na103/rainbow100-gs2/img/DEC_5015687_RainbowGraphicsCard.jpg

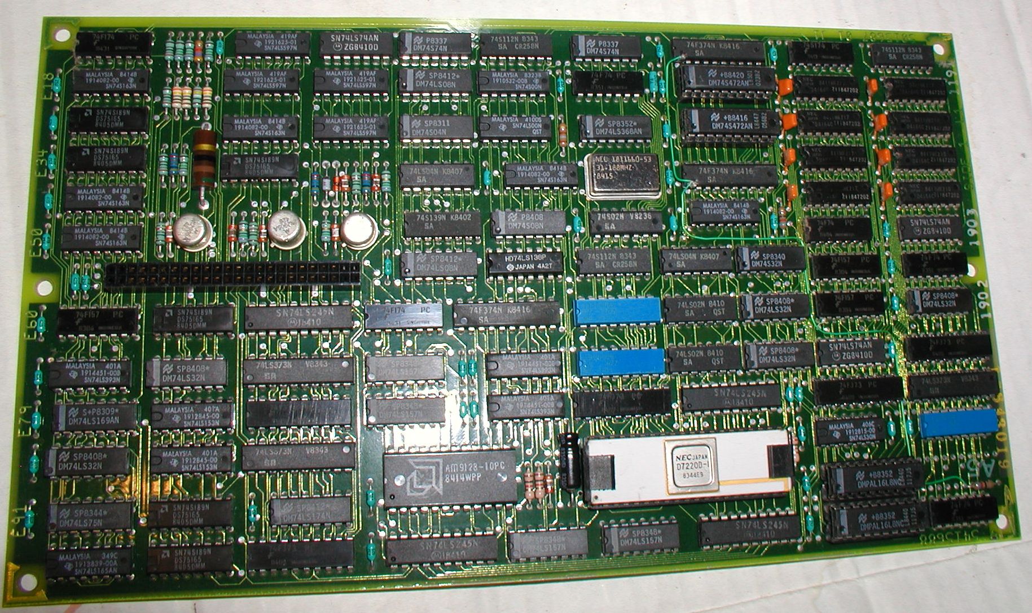
img/DEC_5015687_RainbowGraphicsCard.jpg
