na103/rainbow100-gs2/img/gimp_routing.PNG

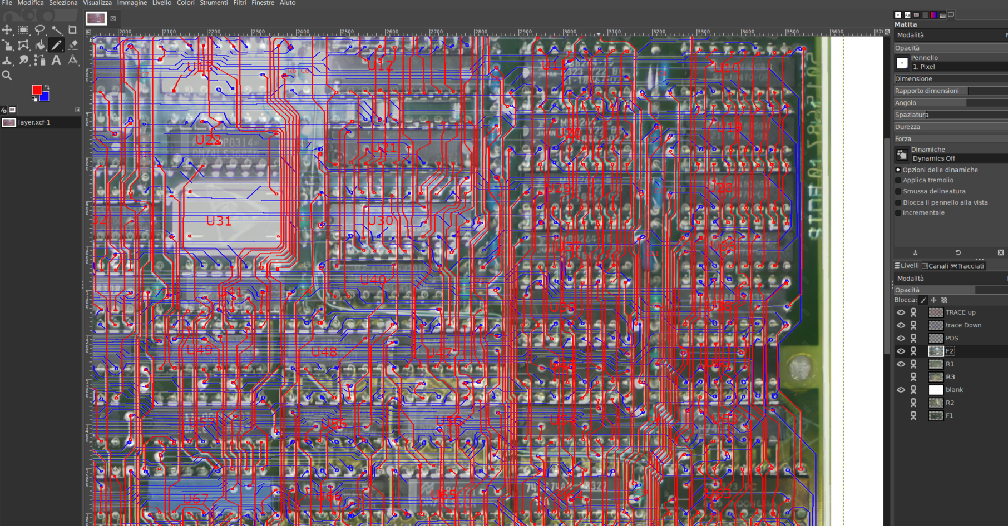
img/gimp_routing.PNG
