na103/rainbow100-gs2/img/routing.png

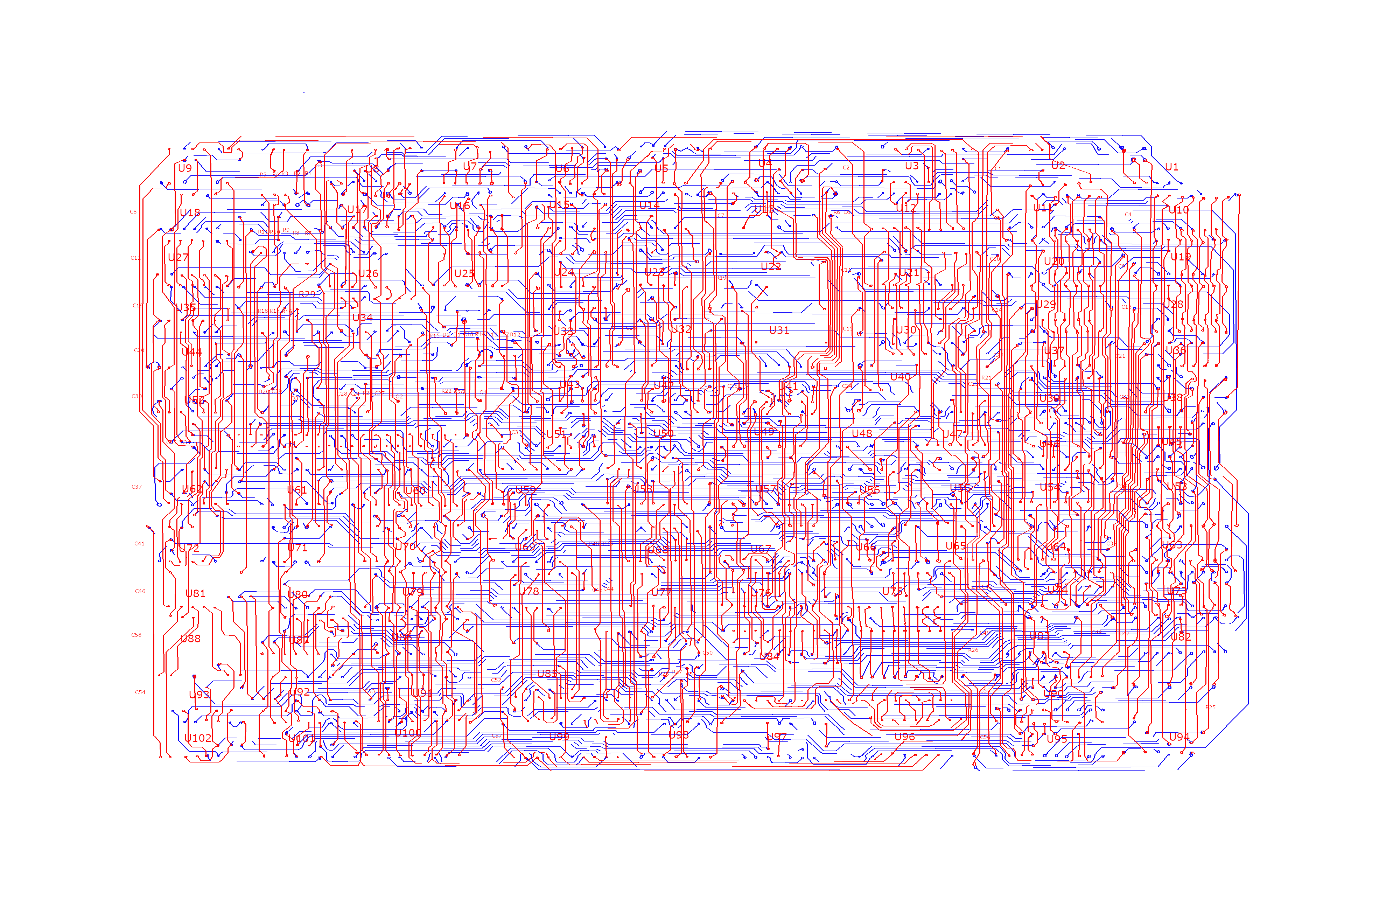
img/routing.png
