na103/rainbow100-gs2/kicad/Graphics-V2/CLUTAddress.sch

## KiCad design kicad/Graphics-V2/CLUTAddress.sch (2023-01-17)

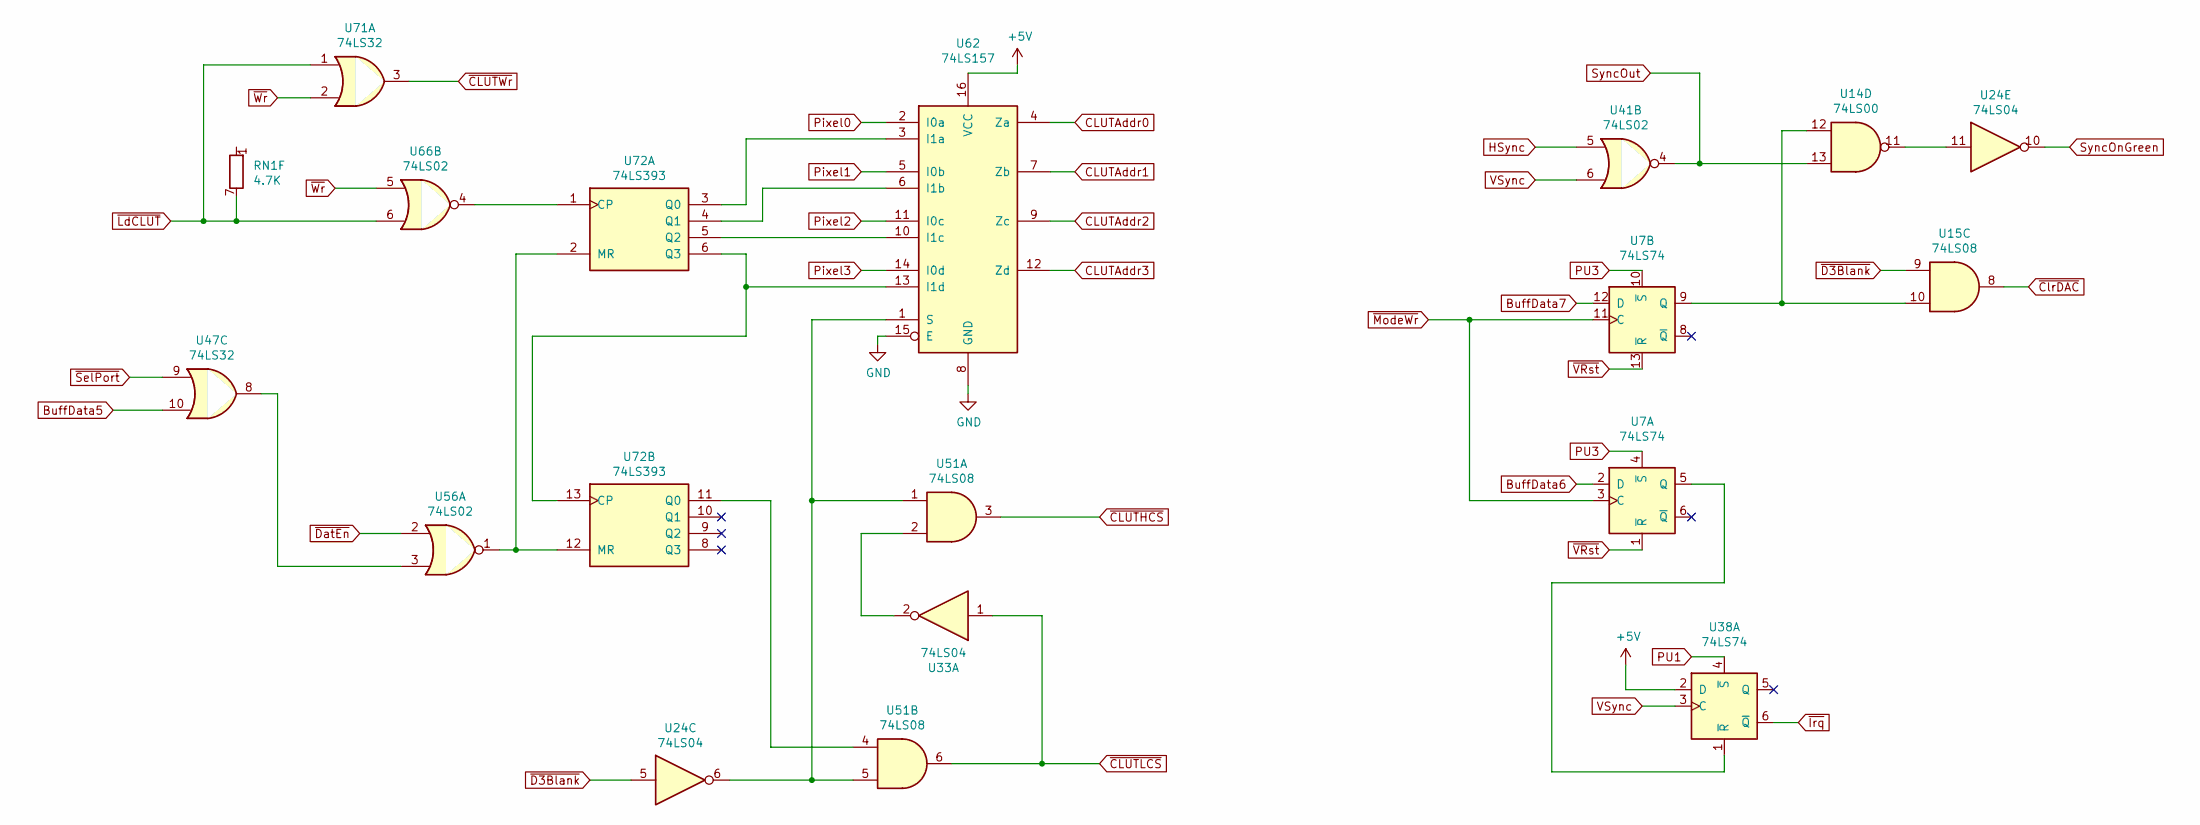
[picture p5: schematic CLUTAddress.sch]

Parts:
RN1: 4.7K; R_Array_SIP8
U7, U38: 74LS74; DIP-14_W7.62mm
U14: 74LS00; DIP-14_W7.62mm
U15, U51: 74LS08; DIP-14_W7.62mm
U24, U33: 74LS04; DIP-14_W7.62mm
U41, U56, U66: 74LS02; DIP-14_W7.62mm
U47, U71: 74LS32; DIP-14_W7.62mm
U62: 74LS157; DIP-16_W7.62mm
U72: 74LS393; DIP-14_W7.62mm

Connections:
+5V: U38.2 (D), U62.16 (VCC)
BuffData5: U47.10
BuffData6: U7.2 (D)
BuffData7: U7.12 (D)
CLUTAddr0: U62.4 (Za)
CLUTAddr1: U62.7 (Zb)
CLUTAddr2: U62.9 (Zc)
CLUTAddr3: U62.12 (Zd)
GND: U62.8 (GND), U62.15 (E)
HSync: U41.5
unnamed: U14.11, U24.11
unnamed: U7.9 (Q), U14.12, U15.10
unnamed: U24.6, U51.1, U51.5, U62.1 (S)
unnamed: U33.2, U51.2
unnamed: U7.5 (Q), U38.1 (~R)
unnamed: U47.8, U56.3
unnamed: U51.4, U72.11 (Q0)
unnamed: U56.1, U72.2 (MR), U72.12 (MR)
unnamed: U62.3 (I1a), U72.3 (Q0)
unnamed: U62.6 (I1b), U72.4 (Q1)
unnamed: U62.10 (I1c), U72.5 (Q2)
unnamed: U62.13 (I1d), U72.6 (Q3), U72.13 (CP)
unnamed: U66.4, U72.1 (CP)
PU1: U38.4 (~S)
PU3: U7.4 (~S), U7.10 (~S)
Pixel0: U62.2 (I0a)
Pixel1: U62.5 (I0b)
Pixel2: U62.11 (I0c)
Pixel3: U62.14 (I0d)
SyncOnGreen: U24.10
SyncOut: U14.13, U41.4
VSync: U38.3 (C), U41.6
~CLUTHCS: U51.3
~CLUTLCS: U33.1, U51.6
~CLUTWr: U71.3
~ClrDAC: U15.8
~D3Blank: U15.9, U24.5
~DatEn: U56.2
~Irq: U38.6 (~Q)
~LdCLUT: RN1.7 (R6.2), U66.6, U71.1
~ModeWr: U7.3 (C), U7.11 (C)
~SelPort: U47.9
~VRst: U7.1 (~R), U7.13 (~R)
~Wr: U66.5, U71.2
