na103/rainbow100-gs2/kicad/Graphics-V2/ColorLUT.sch

## KiCad design kicad/Graphics-V2/ColorLUT.sch (2023-01-17)

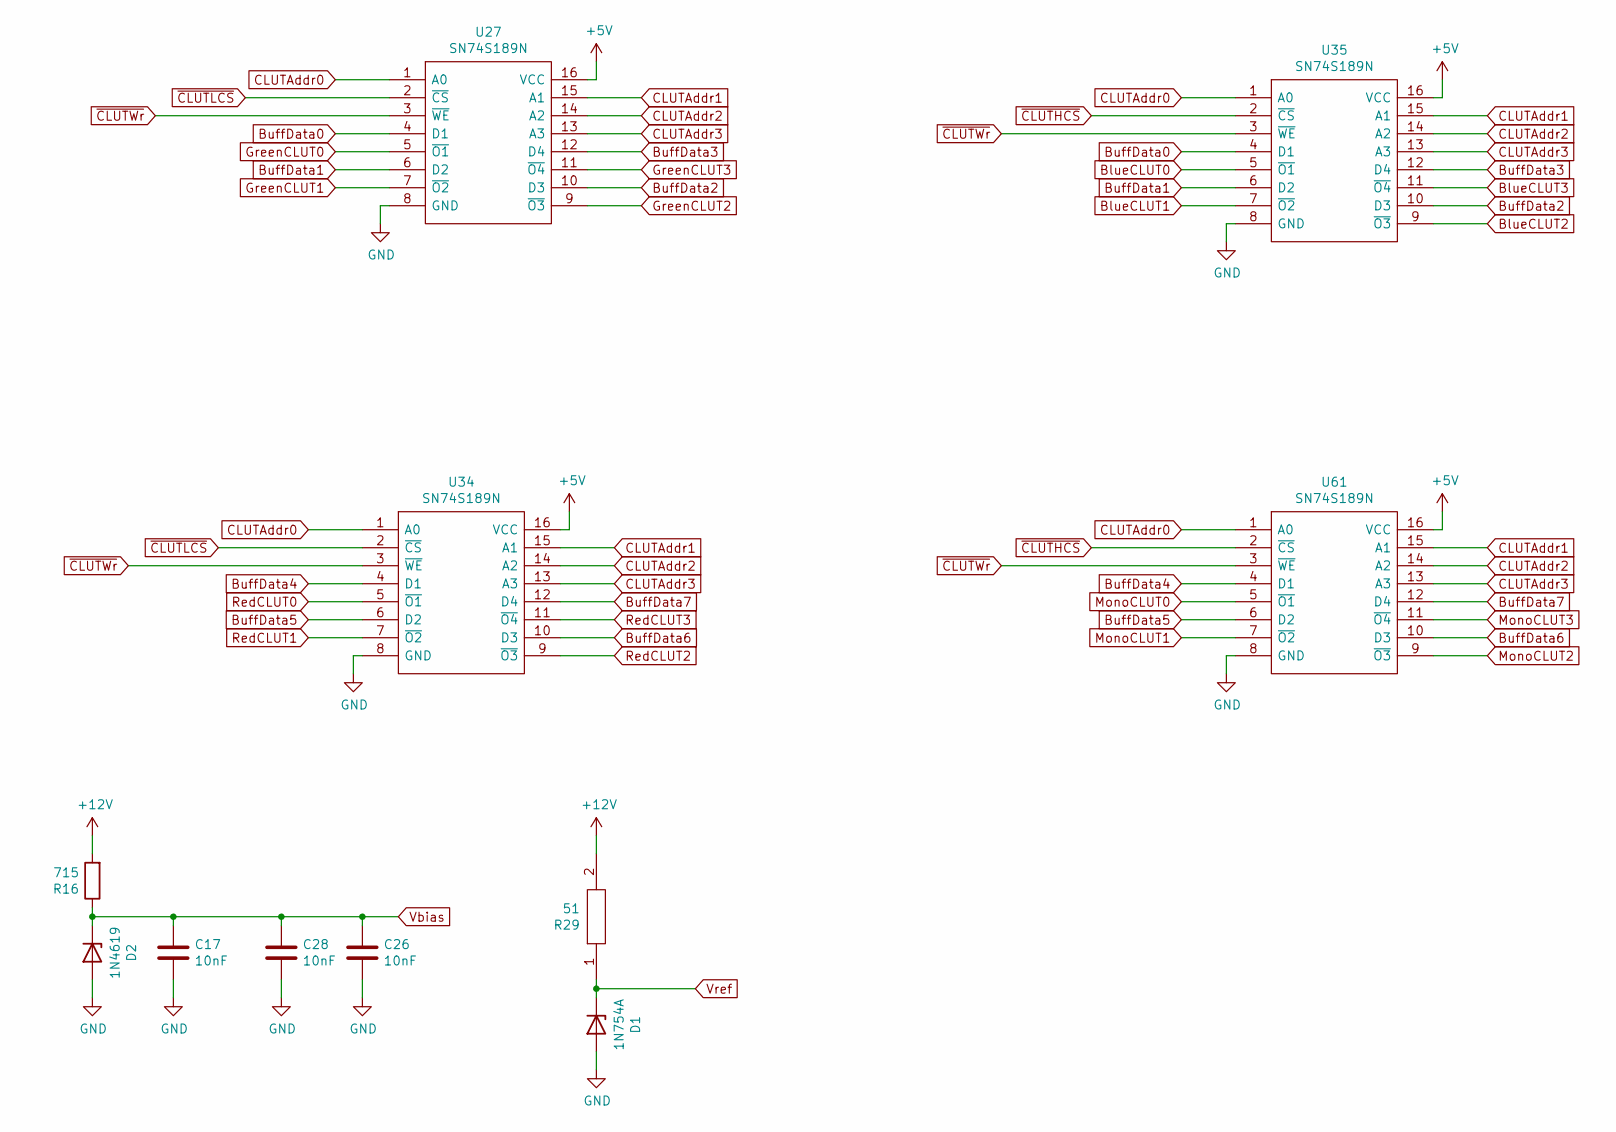
[picture p6: schematic ColorLUT.sch]

Parts:
C17, C26, C28: 10nF; C_Axial_L3.8mm_D2.6mm_P10.00mm_Horizontal
D1: 1N754A; D_DO-35_SOD27_P10.16mm_Horizontal
D2: 1N4619; D_DO-35_SOD27_P10.16mm_Horizontal
R16: 715; R_Axial_DIN0207_L6.3mm_D2.5mm_P10.16mm_Horizontal
R29: 51; RESAD2968W80L1140D457; Mouser Part Number 588-WHC51RFET
U27, U34, U35, U61: SN74S189N; DIP-16_W7.62mm_Socket; Manufacturer_Part_Number SN74S189N

Connections:
+5V: U27.16 (VCC), U34.16 (VCC), U35.16 (VCC), U61.16 (VCC)
+12V: R16.2, R29.2
BlueCLUT0: U35.5 (~O1)
BlueCLUT1: U35.7 (~O2)
BlueCLUT2: U35.9 (~O3)
BlueCLUT3: U35.11 (~O4)
BuffData0: U27.4 (D1), U35.4 (D1)
BuffData1: U27.6 (D2), U35.6 (D2)
BuffData2: U27.10 (D3), U35.10 (D3)
BuffData3: U27.12 (D4), U35.12 (D4)
BuffData4: U34.4 (D1), U61.4 (D1)
BuffData5: U34.6 (D2), U61.6 (D2)
BuffData6: U34.10 (D3), U61.10 (D3)
BuffData7: U34.12 (D4), U61.12 (D4)
CLUTAddr0: U27.1 (A0), U34.1 (A0), U35.1 (A0), U61.1 (A0)
CLUTAddr1: U27.15 (A1), U34.15 (A1), U35.15 (A1), U61.15 (A1)
CLUTAddr2: U27.14 (A2), U34.14 (A2), U35.14 (A2), U61.14 (A2)
CLUTAddr3: U27.13 (A3), U34.13 (A3), U35.13 (A3), U61.13 (A3)
GND: C17.2, C26.2, C28.2, D1.2 (A), D2.2 (A), U27.8 (GND), U34.8 (GND), U35.8 (GND), U61.8 (GND)
GreenCLUT0: U27.5 (~O1)
GreenCLUT1: U27.7 (~O2)
GreenCLUT2: U27.9 (~O3)
GreenCLUT3: U27.11 (~O4)
MonoCLUT0: U61.5 (~O1)
MonoCLUT1: U61.7 (~O2)
MonoCLUT2: U61.9 (~O3)
MonoCLUT3: U61.11 (~O4)
RedCLUT0: U34.5 (~O1)
RedCLUT1: U34.7 (~O2)
RedCLUT2: U34.9 (~O3)
RedCLUT3: U34.11 (~O4)
Vbias: C17.1, C26.1, C28.1, D2.1 (K), R16.1
Vref: D1.1 (K), R29.1
~CLUTHCS: U35.2 (~CS), U61.2 (~CS)
~CLUTLCS: U27.2 (~CS), U34.2 (~CS)
~CLUTWr: U27.3 (~WE), U34.3 (~WE), U35.3 (~WE), U61.3 (~WE)
