na103/rainbow100-gs2/kicad/Graphics-V2/CombinerControl.sch

## KiCad design kicad/Graphics-V2/CombinerControl.sch (2023-01-17)

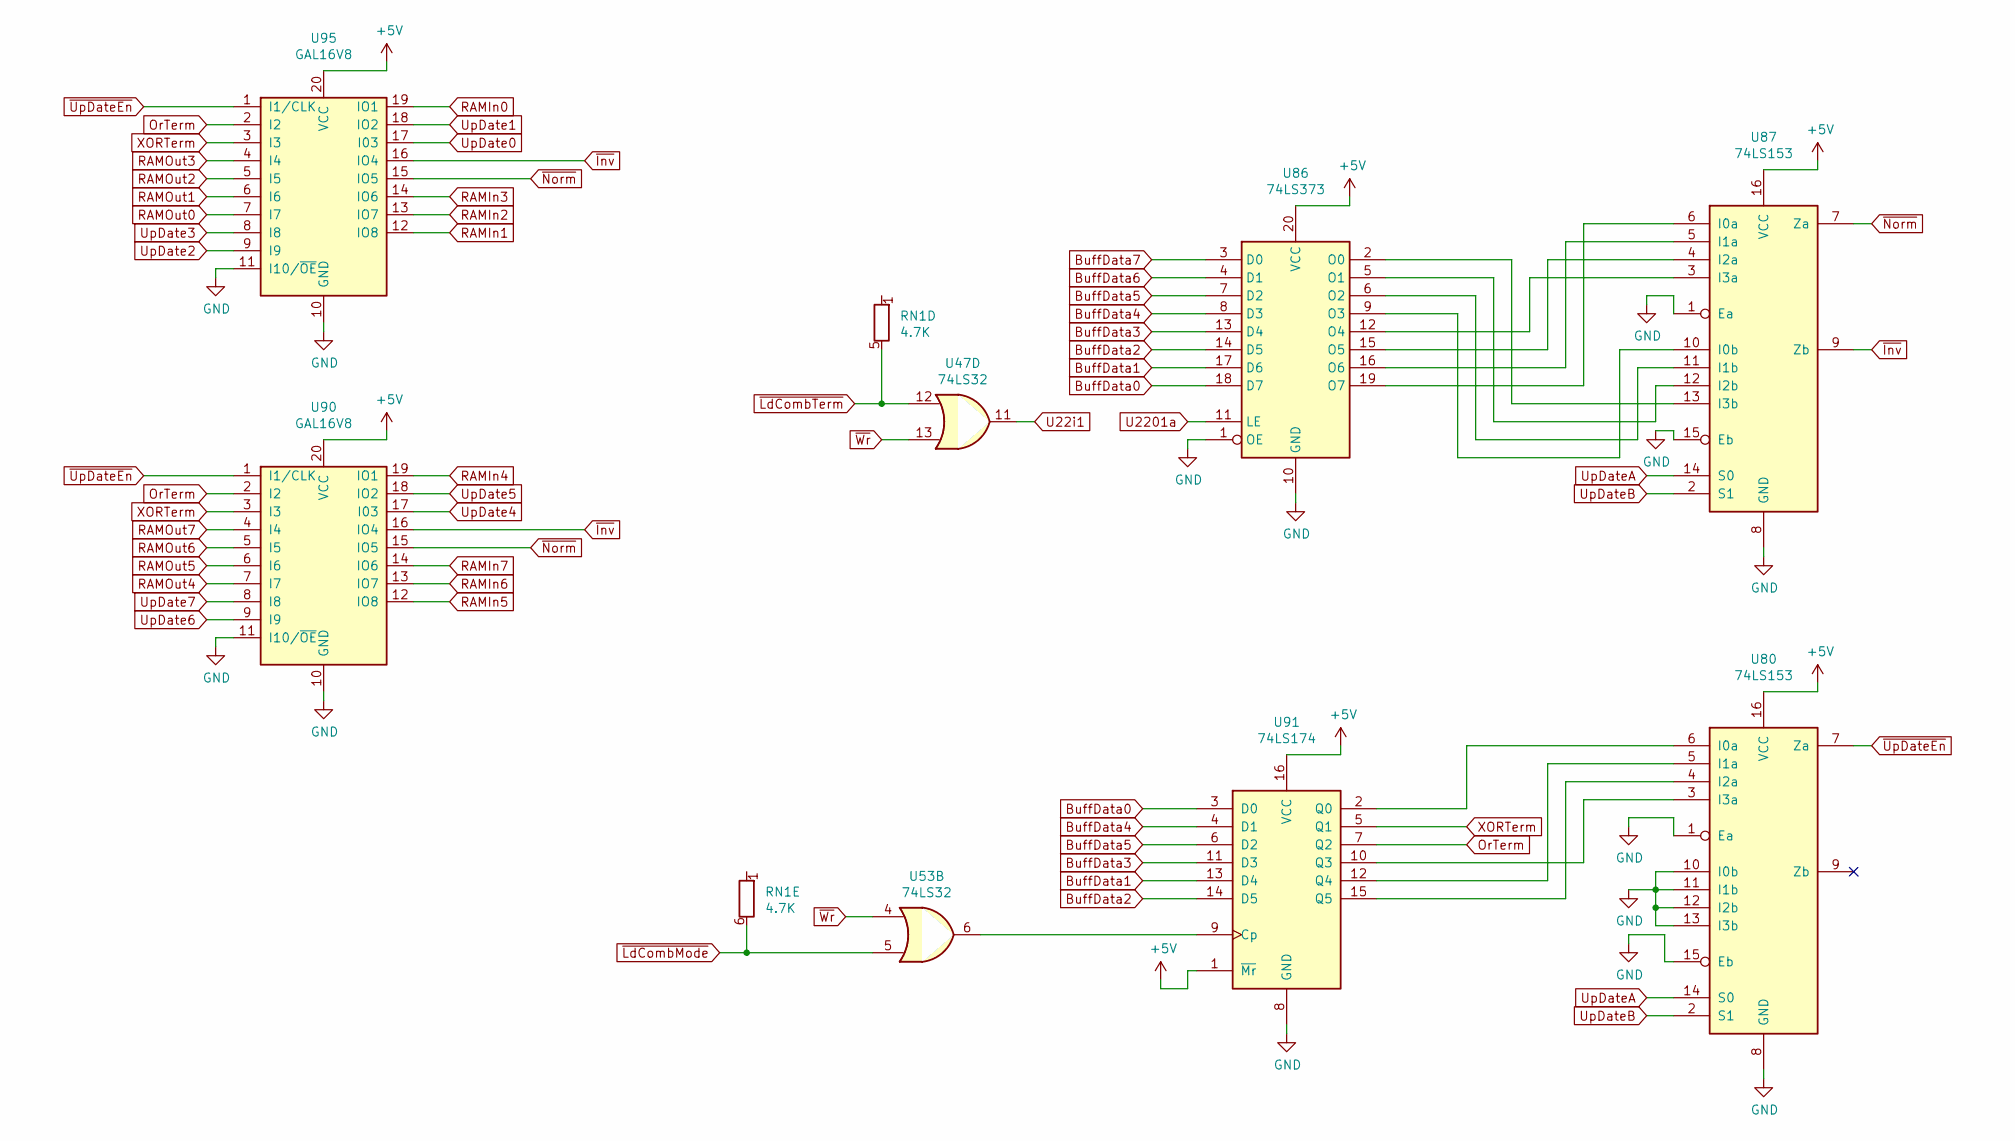
[picture p7: schematic CombinerControl.sch]

Parts:
RN1: 4.7K; R_Array_SIP8
U47, U53: 74LS32; DIP-14_W7.62mm
U80, U87: 74LS153; DIP-16_W7.62mm
U86: 74LS373; DIP-20_W7.62mm
U90, U95: GAL16V8; DIP-20_W7.62mm_Socket
U91: 74LS174; DIP-16_W7.62mm

Connections:
+5V: U80.16 (VCC), U86.20 (VCC), U87.16 (VCC), U90.20 (VCC), U91.1 (~Mr), U91.16 (VCC), U95.20 (VCC)
BuffData0: U86.18 (D7), U91.3 (D0)
BuffData1: U86.17 (D6), U91.13 (D4)
BuffData2: U86.14 (D5), U91.14 (D5)
BuffData3: U86.13 (D4), U91.11 (D3)
BuffData4: U86.8 (D3), U91.4 (D1)
BuffData5: U86.7 (D2), U91.6 (D2)
BuffData6: U86.4 (D1)
BuffData7: U86.3 (D0)
GND: U80.1 (Ea), U80.8 (GND), U80.10 (I0b), U80.11 (I1b), U80.12 (I2b), U80.13 (I3b), U80.15 (Eb), U86.1 (OE), U86.10 (GND), U87.1 (Ea), U87.8 (GND), U87.15 (Eb), U90.10 (GND), U90.11 (I10/~OE~), U91.8 (GND), U95.10 (GND), U95.11 (I10/~OE~)
unnamed: U53.6, U91.9 (Cp)
unnamed: U80.3 (I3a), U91.10 (Q3)
unnamed: U80.4 (I2a), U91.15 (Q5)
unnamed: U80.5 (I1a), U91.12 (Q4)
unnamed: U80.6 (I0a), U91.2 (Q0)
unnamed: U86.2 (O0), U87.13 (I3b)
unnamed: U86.5 (O1), U87.12 (I2b)
unnamed: U86.6 (O2), U87.11 (I1b)
unnamed: U86.9 (O3), U87.10 (I0b)
unnamed: U86.12 (O4), U87.3 (I3a)
unnamed: U86.15 (O5), U87.4 (I2a)
unnamed: U86.16 (O6), U87.5 (I1a)
unnamed: U86.19 (O7), U87.6 (I0a)
OrTerm: U90.2 (I2), U91.7 (Q2), U95.2 (I2)
RAMIn0: U95.19 (IO1)
RAMIn1: U95.12 (IO8)
RAMIn2: U95.13 (IO7)
RAMIn3: U95.14 (IO6)
RAMIn4: U90.19 (IO1)
RAMIn5: U90.12 (IO8)
RAMIn6: U90.13 (IO7)
RAMIn7: U90.14 (IO6)
RAMOut0: U95.7 (I7)
RAMOut1: U95.6 (I6)
RAMOut2: U95.5 (I5)
RAMOut3: U95.4 (I4)
RAMOut4: U90.7 (I7)
RAMOut5: U90.6 (I6)
RAMOut6: U90.5 (I5)
RAMOut7: U90.4 (I4)
U22i1: U47.11
U2201a: U86.11 (LE)
UpDate0: U95.17 (I03)
UpDate1: U95.18 (IO2)
UpDate2: U95.9 (I9)
UpDate3: U95.8 (I8)
UpDate4: U90.17 (I03)
UpDate5: U90.18 (IO2)
UpDate6: U90.9 (I9)
UpDate7: U90.8 (I8)
UpDateA: U80.14 (S0), U87.14 (S0)
UpDateB: U80.2 (S1), U87.2 (S1)
XORTerm: U90.3 (I3), U91.5 (Q1), U95.3 (I3)
~Inv: U87.9 (Zb), U90.16 (IO4), U95.16 (IO4)
~LdCombMode: RN1.6 (R5.2), U53.5
~LdCombTerm: RN1.5 (R4.2), U47.12
~Norm: U87.7 (Za), U90.15 (IO5), U95.15 (IO5)
~UpDateEn: U80.7 (Za), U90.1 (I1/CLK), U95.1 (I1/CLK)
~Wr: U47.13, U53.4
