na103/rainbow100-gs2/kicad/Graphics-V2/ControlPort.sch

## KiCad design kicad/Graphics-V2/ControlPort.sch (2023-01-17)

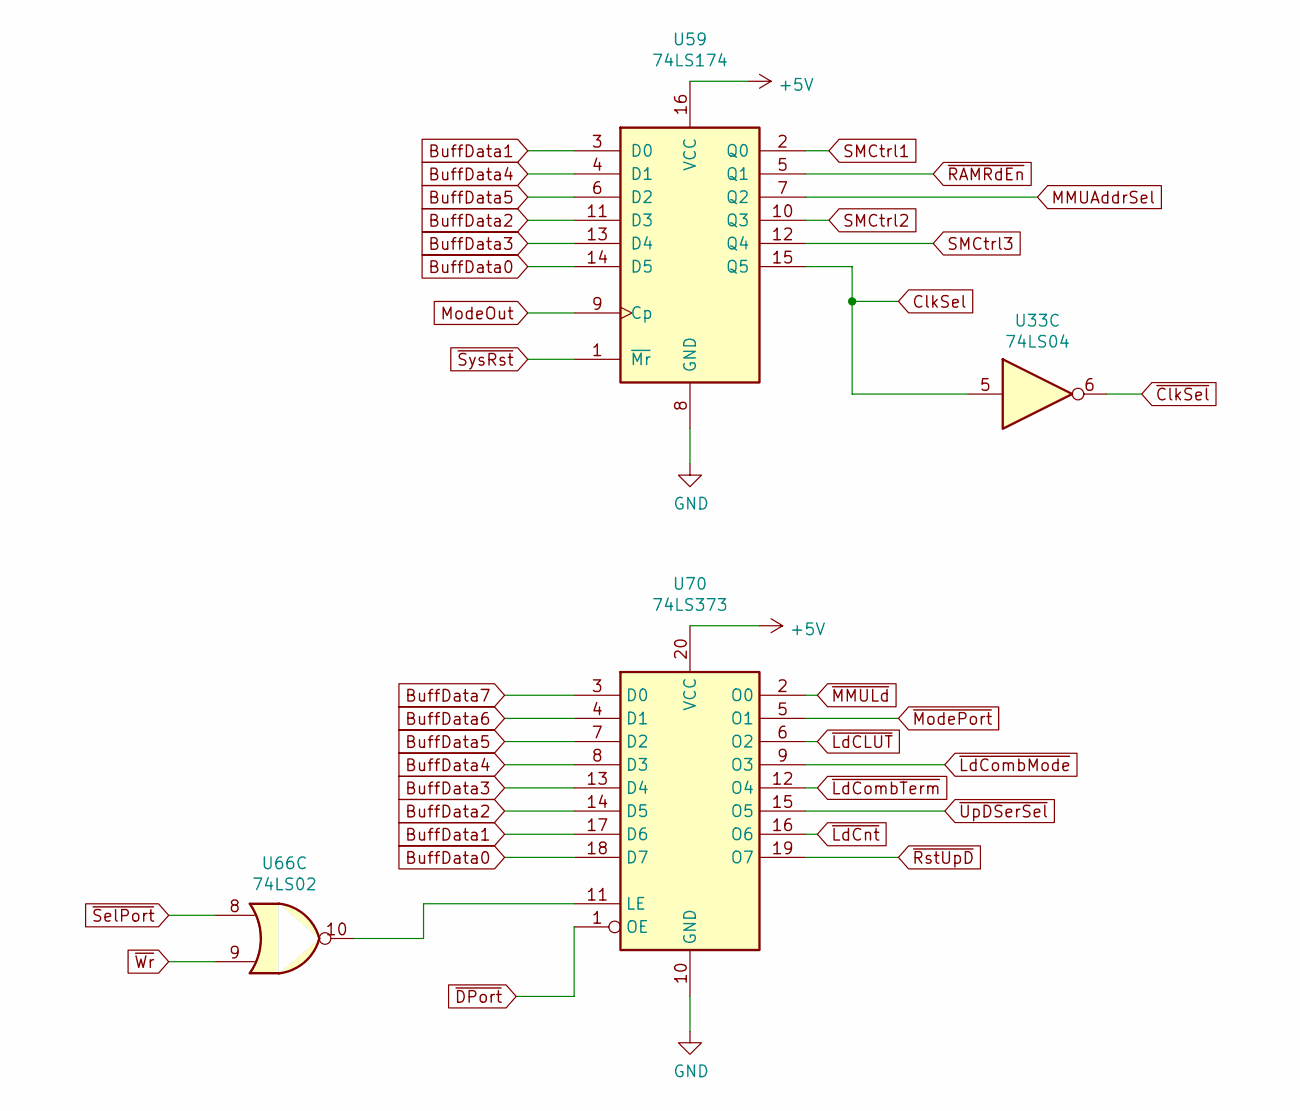
[picture p8: schematic ControlPort.sch]

Parts:
U33: 74LS04; DIP-14_W7.62mm
U59: 74LS174; DIP-16_W7.62mm
U66: 74LS02; DIP-14_W7.62mm
U70: 74LS373; DIP-20_W7.62mm

Connections:
+5V: U59.16 (VCC), U70.20 (VCC)
BuffData0: U59.14 (D5), U70.18 (D7)
BuffData1: U59.3 (D0), U70.17 (D6)
BuffData2: U59.11 (D3), U70.14 (D5)
BuffData3: U59.13 (D4), U70.13 (D4)
BuffData4: U59.4 (D1), U70.8 (D3)
BuffData5: U59.6 (D2), U70.7 (D2)
BuffData6: U70.4 (D1)
BuffData7: U70.3 (D0)
ClkSel: U33.5, U59.15 (Q5)
GND: U59.8 (GND), U70.10 (GND)
MMUAddrSel: U59.7 (Q2)
ModeOut: U59.9 (Cp)
unnamed: U66.10, U70.11 (LE)
SMCtrl1: U59.2 (Q0)
SMCtrl2: U59.10 (Q3)
SMCtrl3: U59.12 (Q4)
~ClkSel: U33.6
~DPort: U70.1 (OE)
~LdCLUT: U70.6 (O2)
~LdCnt: U70.16 (O6)
~LdCombMode: U70.9 (O3)
~LdCombTerm: U70.12 (O4)
~MMULd: U70.2 (O0)
~ModePort: U70.5 (O1)
~RAMRdEn: U59.5 (Q1)
~RstUpD: U70.19 (O7)
~SelPort: U66.8
~SysRst: U59.1 (~Mr)
~UpDSerSel: U70.15 (O5)
~Wr: U66.9
