na103/rainbow100-gs2/kicad/Graphics-V2/DataBufferControl.sch

## KiCad design kicad/Graphics-V2/DataBufferControl.sch (2023-01-17)

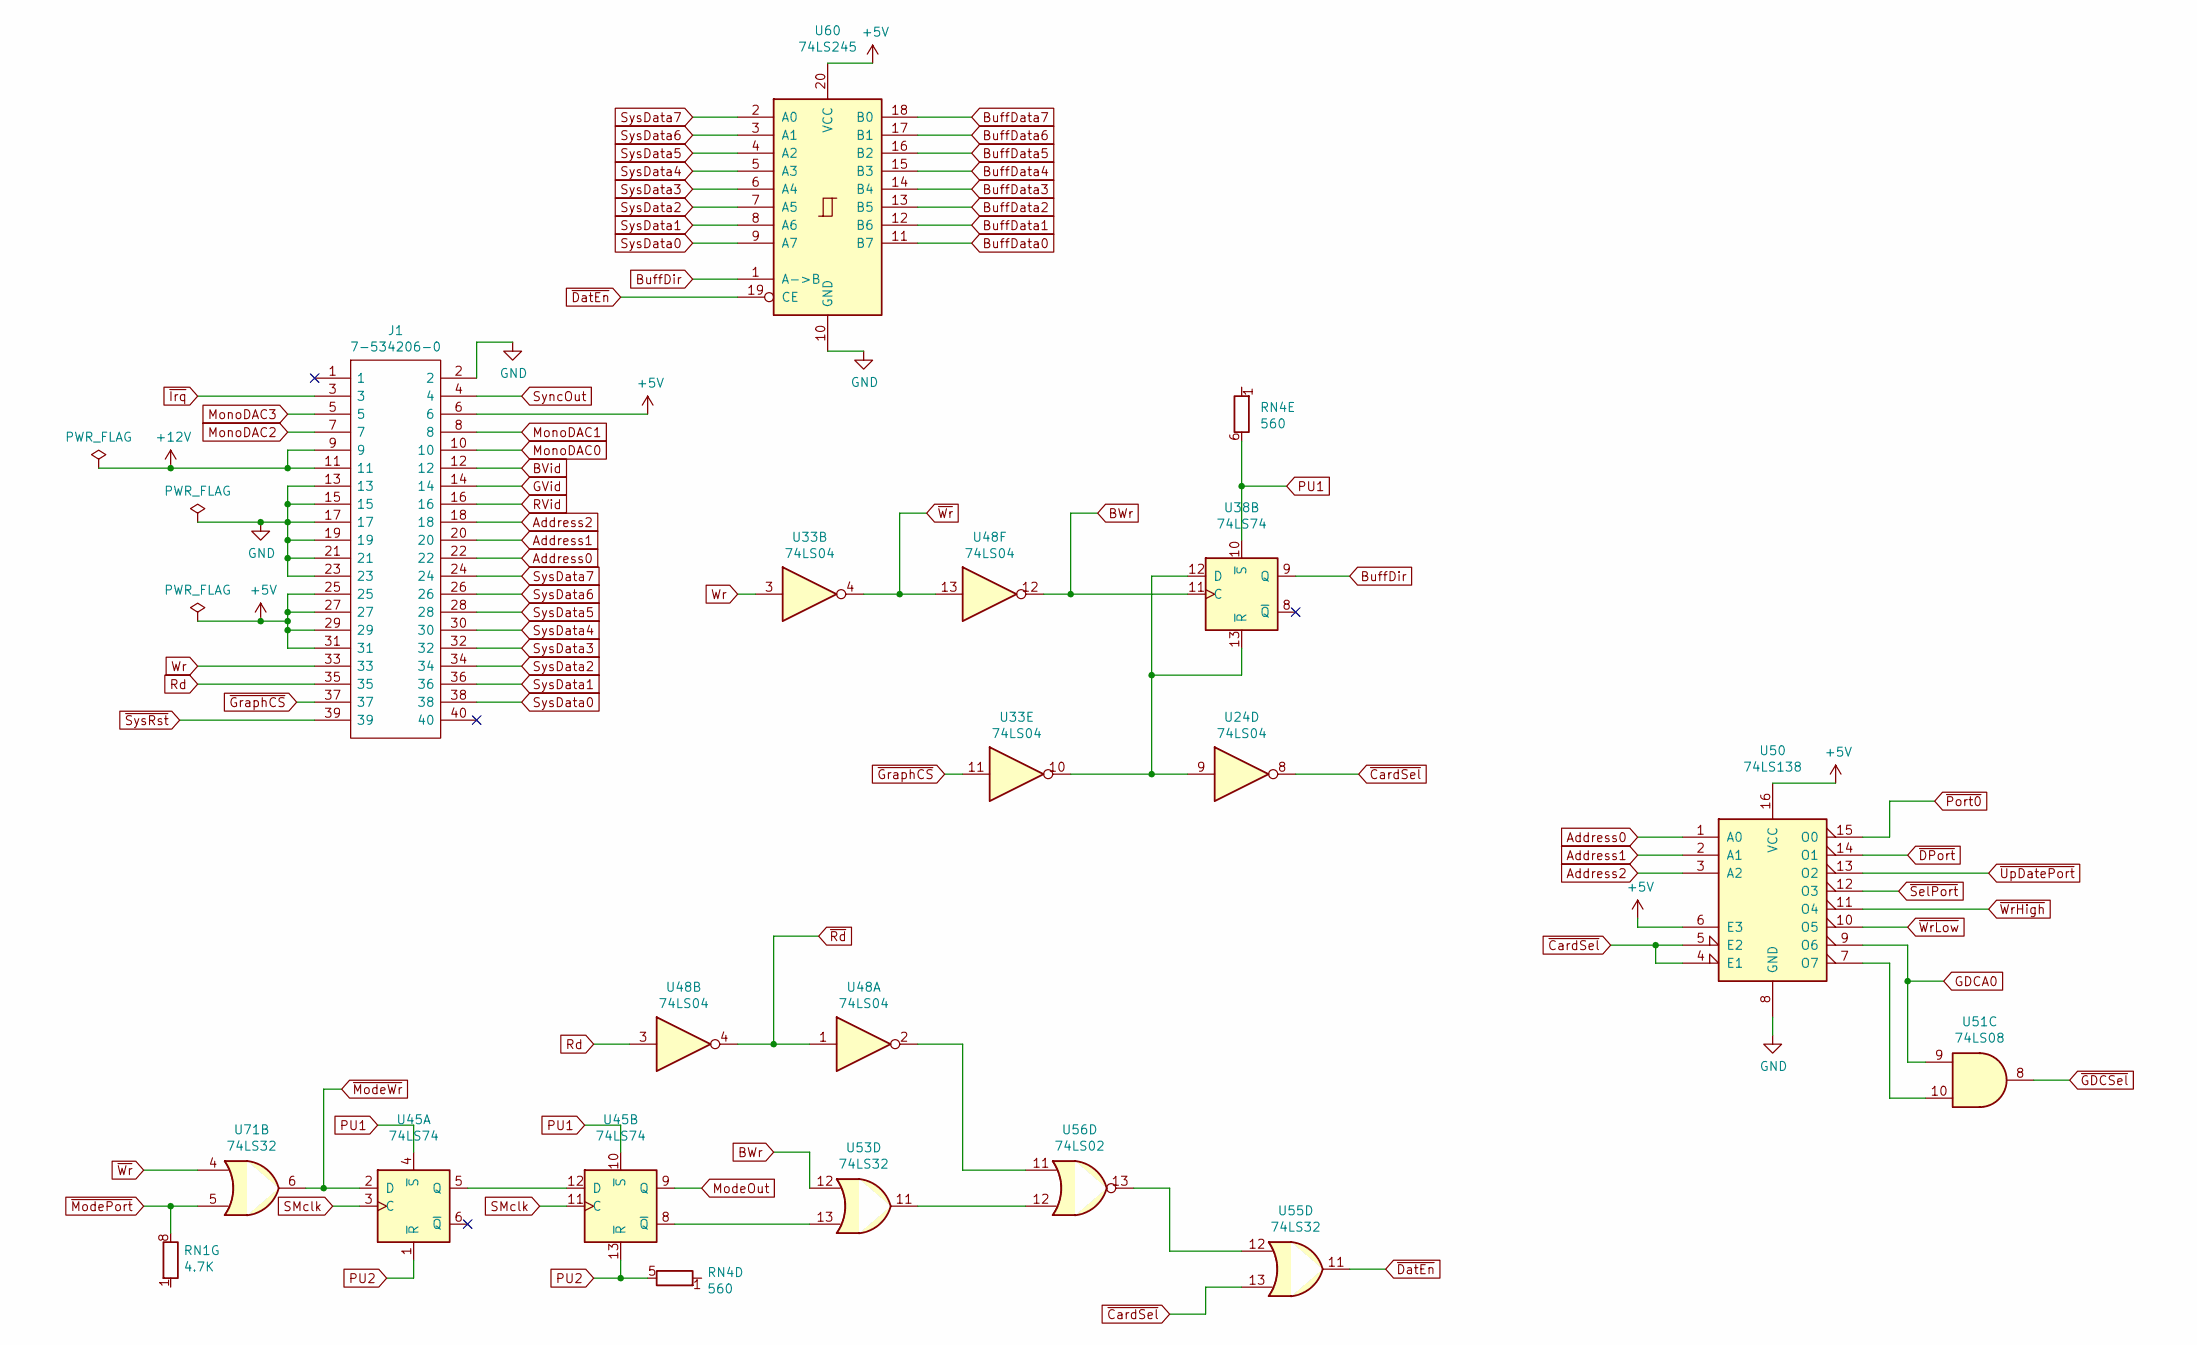
[picture p9: schematic DataBufferControl.sch]

Parts:
J1: 7-534206-0; SHDR40W69P254_2X20_5080X503X813P; Mouser Part Number 571-7-534206-0
RN1: 4.7K; R_Array_SIP8
RN4: 560; R_Array_SIP8
U24, U33, U48: 74LS04; DIP-14_W7.62mm
U38, U45: 74LS74; DIP-14_W7.62mm
U50: 74LS138; DIP-16_W7.62mm
U51: 74LS08; DIP-14_W7.62mm
U53, U55, U71: 74LS32; DIP-14_W7.62mm
U56: 74LS02; DIP-14_W7.62mm
U60: 74LS245; DIP-20_W7.62mm

Connections:
+5V: J1.6, J1.25, J1.27, J1.29, J1.31, U50.6 (E3), U50.16 (VCC), U60.20 (VCC)
+12V: J1.9, J1.11
Address0: J1.22, U50.1 (A0)
Address1: J1.20, U50.2 (A1)
Address2: J1.18, U50.3 (A2)
BVid: J1.12
BWr: U38.11 (C), U48.12, U53.12
BuffData0: U60.11 (B7)
BuffData1: U60.12 (B6)
BuffData2: U60.13 (B5)
BuffData3: U60.14 (B4)
BuffData4: U60.15 (B3)
BuffData5: U60.16 (B2)
BuffData6: U60.17 (B1)
BuffData7: U60.18 (B0)
BuffDir: U38.9 (Q), U60.1 (A->B)
GDCA0: U50.9 (O6), U51.9
GND: J1.2, J1.13, J1.15, J1.17, J1.19, J1.21, J1.23, U50.8 (GND), U60.10 (GND)
GVid: J1.14
ModeOut: U45.9 (Q)
MonoDAC0: J1.10
MonoDAC1: J1.8
MonoDAC2: J1.7
MonoDAC3: J1.5
unnamed: U24.9, U33.10, U38.12 (D), U38.13 (~R)
unnamed: U45.8 (~Q), U53.13
unnamed: U45.5 (Q), U45.12 (D)
unnamed: U48.2, U56.11
unnamed: U50.7 (O7), U51.10
unnamed: U53.11, U56.12
unnamed: U55.12, U56.13
PU1: RN4.6 (R5.2), U38.10 (~S), U45.4 (~S), U45.10 (~S)
PU2: RN4.5 (R4.2), U45.1 (~R), U45.13 (~R)
RVid: J1.16
Rd: J1.35, U48.3
SMclk: U45.3 (C), U45.11 (C)
SyncOut: J1.4
SysData0: J1.38, U60.9 (A7)
SysData1: J1.36, U60.8 (A6)
SysData2: J1.34, U60.7 (A5)
SysData3: J1.32, U60.6 (A4)
SysData4: J1.30, U60.5 (A3)
SysData5: J1.28, U60.4 (A2)
SysData6: J1.26, U60.3 (A1)
SysData7: J1.24, U60.2 (A0)
Wr: J1.33, U33.3
~CardSel: U24.8, U50.4 (E1), U50.5 (E2), U55.13
~DPort: U50.14 (O1)
~DatEn: U55.11, U60.19 (CE)
~GDCSel: U51.8
~GraphCS: J1.37, U33.11
~Irq: J1.3
~ModePort: RN1.8 (R7.2), U71.5
~ModeWr: U45.2 (D), U71.6
~Port0: U50.15 (O0)
~Rd: U48.1, U48.4
~SelPort: U50.12 (O3)
~SysRst: J1.39
~UpDatePort: U50.13 (O2)
~Wr: U33.4, U48.13, U71.4
~WrHigh: U50.11 (O4)
~WrLow: U50.10 (O5)
