na103/rainbow100-gs2/kicad/Graphics-V2/Graphics.sch

## KiCad design kicad/Graphics-V2/Graphics.sch (2023-01-17)

Schematic: Graphics.sch

Parts:
C1, C2, C3, C6, C7, C8, C11, C12, C15, C16, C19, C20, C23, C24, C25, C30, C31, C32, C33, C34, C35, C36, C37, C38, C39, C40, C41, C42, C43, C44, C45, C46, C47, C48, C49, C52, C53, C54, C55, C56, C57, C58: 47nF; C_Axial_L3.8mm_D2.6mm_P7.50mm_Horizontal
C4, C5, C9, C10, C13, C14, C21, C22: 220nF; C_Axial_L3.8mm_D2.6mm_P7.50mm_Horizontal
C50: 4.7uF; CP_Axial_L11.0mm_D5.0mm_P18.00mm_Horizontal
C51: 10nF; C_Axial_L3.8mm_D2.6mm_P10.00mm_Horizontal
RN2: 4.7K; R_Array_SIP8
RN4: 560; R_Array_SIP8
U1, U5, U49: 74LS112; DIP-16_W7.62mm
U4, U6, U7, U13, U38, U39, U45, U64, U94: 74LS74; DIP-14_W7.62mm
U14, U23: 74LS00; DIP-14_W7.62mm
U15, U42, U51: 74LS08; DIP-14_W7.62mm
U24, U33, U48: 74LS04; DIP-14_W7.62mm
U41, U56, U66: 74LS02; DIP-14_W7.62mm
U43: 74LS139; DIP-16_W7.62mm
U47, U53, U55, U65, U71, U88: 74LS32; DIP-14_W7.62mm
U68, U72, U77: 74LS393; DIP-14_W7.62mm
U83: 74LS30; DIP-14_W7.62mm

Connections:
+5V: C1.2, C2.2, C3.2, C4.2, C5.2, C6.2, C7.2, C8.2, C9.2, C10.2, C11.2, C12.2, C13.2, C14.2, C15.2, C16.2, C19.2, C20.2, C21.2, C22.2, C23.2, C24.2, C25.2, C30.2, C31.2, C32.2, C33.2, C34.2, C35.2, C36.2, C37.2, C38.2, C39.2, C40.2, C41.2, C42.2, C43.2, C44.2, C45.2, C46.2, C47.2, C48.2, C49.2, C50.2, C51.2, C52.2, C53.2, C54.2, C55.2, C56.2, C57.2, C58.2, RN4.1 (R1.1), U1.16 (VCC), U4.14 (VCC), U5.16 (VCC), U6.14 (VCC), U7.14 (VCC), U13.14 (VCC), U14.14 (VCC), U15.14 (VCC), U23.14 (VCC), U24.14 (VCC), U33.14 (VCC), U38.14 (VCC), U39.14 (VCC), U41.14 (VCC), U42.14 (VCC), U43.16 (VCC), U45.14 (VCC), U47.14 (VCC), U48.14 (VCC), U49.16 (VCC), U51.14 (VCC), U53.14 (VCC), U55.14 (VCC), U56.14 (VCC), U64.14 (VCC), U65.14 (VCC), U66.14 (VCC), U68.14 (VCC), U71.14 (VCC), U72.14 (VCC), U77.14 (VCC), U83.14 (VCC), U88.14 (VCC), U94.14 (VCC)
GND: C1.1, C2.1, C3.1, C4.1, C5.1, C6.1, C7.1, C8.1, C9.1, C10.1, C11.1, C12.1, C13.1, C14.1, C15.1, C16.1, C19.1, C20.1, C21.1, C22.1, C23.1, C24.1, C25.1, C30.1, C31.1, C32.1, C33.1, C34.1, C35.1, C36.1, C37.1, C38.1, C39.1, C40.1, C41.1, C42.1, C43.1, C44.1, C45.1, C46.1, C47.1, C48.1, C49.1, C50.1, C51.1, C52.1, C53.1, C54.1, C55.1, C56.1, C57.1, C58.1, U1.8 (GND), U4.7 (GND), U5.8 (GND), U6.7 (GND), U7.7 (GND), U13.7 (GND), U14.7 (GND), U15.7 (GND), U23.7 (GND), U24.7 (GND), U33.7 (GND), U38.7 (GND), U39.7 (GND), U41.7 (GND), U42.7 (GND), U43.8 (GND), U45.7 (GND), U47.7 (GND), U48.7 (GND), U49.8 (GND), U51.7 (GND), U53.7 (GND), U55.7 (GND), U56.7 (GND), U64.7 (GND), U65.7 (GND), U66.7 (GND), U68.7 (GND), U71.7 (GND), U72.7 (GND), U77.7 (GND), U83.7 (GND), U88.7 (GND), U94.7 (GND)
