na103/rainbow100-gs2/kicad/Graphics-V2/MajorStates.sch

## KiCad design kicad/Graphics-V2/MajorStates.sch (2023-01-17)

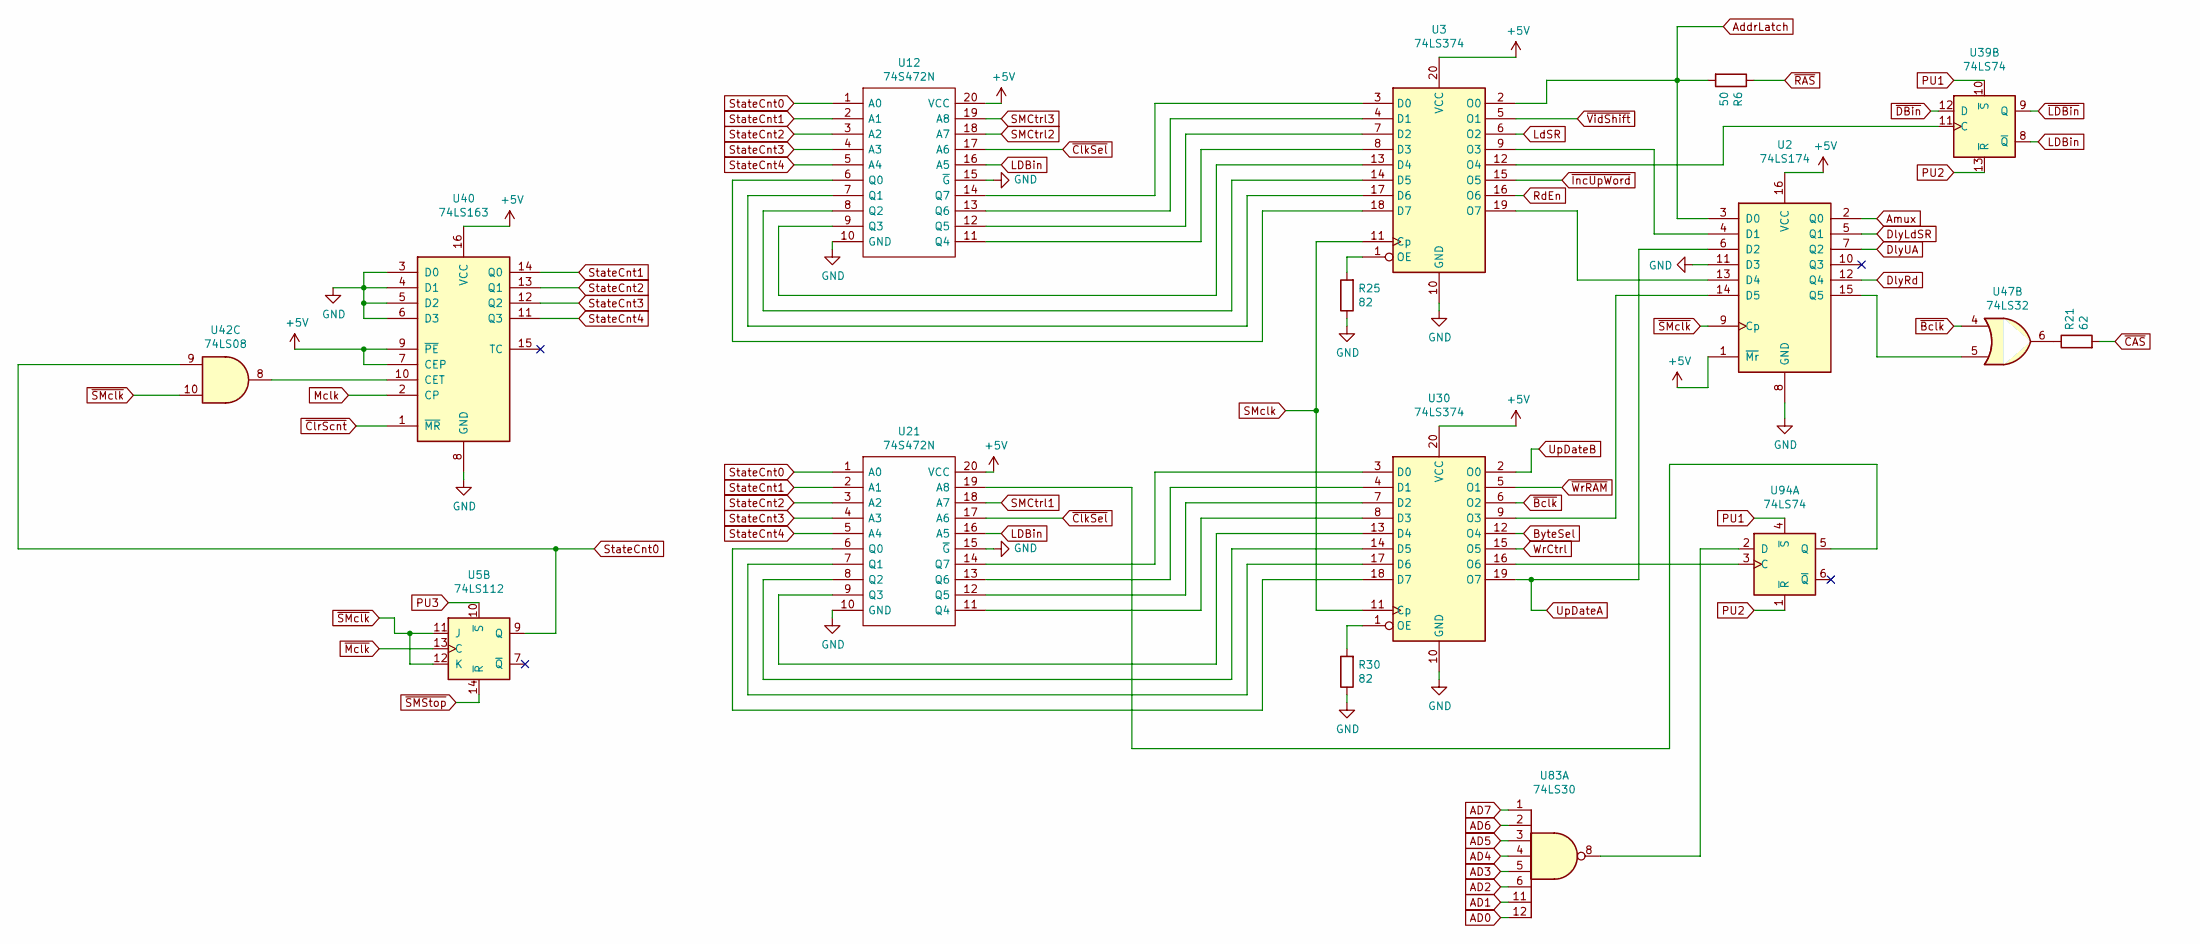
[picture p10: schematic MajorStates.sch]

Parts:
R6: 50; R_Axial_DIN0207_L6.3mm_D2.5mm_P10.16mm_Horizontal
R21: 62; R_Axial_DIN0207_L6.3mm_D2.5mm_P10.16mm_Horizontal
R25, R30: 82; R_Axial_DIN0207_L6.3mm_D2.5mm_P10.16mm_Horizontal
U2: 74LS174; DIP-16_W7.62mm
U3, U30: 74LS374; DIP-20_W7.62mm
U5: 74LS112; DIP-16_W7.62mm
U12, U21: 74S472N; DIP-20_W7.62mm_Socket; Manufacturer_Part_Number 74S472N
U39, U94: 74LS74; DIP-14_W7.62mm
U40: 74LS163; DIP-16_W7.62mm
U42: 74LS08; DIP-14_W7.62mm
U47: 74LS32; DIP-14_W7.62mm
U83: 74LS30; DIP-14_W7.62mm

Connections:
+5V: U2.1 (~Mr), U2.16 (VCC), U3.20 (VCC), U12.20 (VCC), U21.20 (VCC), U30.20 (VCC), U40.7 (CEP), U40.9 (~PE), U40.16 (VCC)
AD0: U83.12
AD1: U83.11
AD2: U83.6
AD3: U83.5
AD4: U83.4
AD5: U83.3
AD6: U83.2
AD7: U83.1
AddrLatch: R6.2, U2.3 (D0), U3.2 (O0)
Amux: U2.2 (Q0)
ByteSel: U30.12 (O4)
DlyLdSR: U2.5 (Q1)
DlyRd: U2.12 (Q4)
DlyUA: U2.7 (Q2)
GND: R25.1, R30.1, U2.8 (GND), U2.11 (D3), U3.10 (GND), U12.10 (GND), U12.15 (~G), U21.10 (GND), U21.15 (~G), U30.10 (GND), U40.3 (D0), U40.4 (D1), U40.5 (D2), U40.6 (D3), U40.8 (GND)
LDBin: U12.16 (A5), U21.16 (A5), U39.8 (~Q)
LdSR: U3.6 (O2)
Mclk: U40.2 (CP)
unnamed: R21.1, U47.6
unnamed: R25.2, U3.1 (OE)
unnamed: R30.2, U30.1 (OE)
unnamed: U2.4 (D1), U3.9 (O3)
unnamed: U2.13 (D4), U3.19 (O7)
unnamed: U2.14 (D5), U30.9 (O3)
unnamed: U2.15 (Q5), U47.5
unnamed: U3.12 (O4), U39.11 (C)
unnamed: U3.18 (D7), U12.6 (Q0)
unnamed: U3.17 (D6), U12.7 (Q1)
unnamed: U3.14 (D5), U12.8 (Q2)
unnamed: U3.13 (D4), U12.9 (Q3)
unnamed: U3.8 (D3), U12.11 (Q4)
unnamed: U3.7 (D2), U12.12 (Q5)
unnamed: U3.4 (D1), U12.13 (Q6)
unnamed: U3.3 (D0), U12.14 (Q7)
unnamed: U21.6 (Q0), U30.18 (D7)
unnamed: U21.7 (Q1), U30.17 (D6)
unnamed: U21.8 (Q2), U30.14 (D5)
unnamed: U21.9 (Q3), U30.13 (D4)
unnamed: U21.11 (Q4), U30.8 (D3)
unnamed: U21.12 (Q5), U30.7 (D2)
unnamed: U21.13 (Q6), U30.4 (D1)
unnamed: U21.14 (Q7), U30.3 (D0)
unnamed: U21.19 (A8), U94.5 (Q)
unnamed: U30.16 (O6), U94.3 (C)
unnamed: U40.10 (CET), U42.8
unnamed: U83.8, U94.2 (D)
PU1: U39.10 (~S), U94.4 (~S)
PU2: U39.13 (~R), U94.1 (~R)
PU3: U5.10 (~S)
RdEn: U3.16 (O6)
SMCtrl1: U21.18 (A7)
SMCtrl2: U12.18 (A7)
SMCtrl3: U12.19 (A8)
SMclk: U3.11 (Cp), U30.11 (Cp)
StateCnt0: U5.9 (Q), U12.1 (A0), U21.1 (A0), U42.9
StateCnt1: U12.2 (A1), U21.2 (A1), U40.14 (Q0)
StateCnt2: U12.3 (A2), U21.3 (A2), U40.13 (Q1)
StateCnt3: U12.4 (A3), U21.4 (A3), U40.12 (Q2)
StateCnt4: U12.5 (A4), U21.5 (A4), U40.11 (Q3)
UpDateA: U2.6 (D2), U30.19 (O7)
UpDateB: U30.2 (O0)
WrCtrl: U30.15 (O5)
~Bclk: U30.6 (O2), U47.4
~CAS: R21.2
~ClkSel: U12.17 (A6), U21.17 (A6)
~ClrScnt: U40.1 (~MR)
~DBin: U39.12 (D)
~IncUpWord: U3.15 (O5)
~LDBin: U39.9 (Q)
~Mclk: U5.13 (C)
~RAS: R6.1
~SMStop: U5.14 (~R)
~SMclk: U2.9 (Cp), U5.11 (J), U5.12 (K), U42.10
~VidShift: U3.5 (O1)
~WrRAM: U30.5 (O1)
