na103/rainbow100-gs2/kicad/Graphics-V2/MasterClock.sch

## KiCad design kicad/Graphics-V2/MasterClock.sch (2023-01-17)

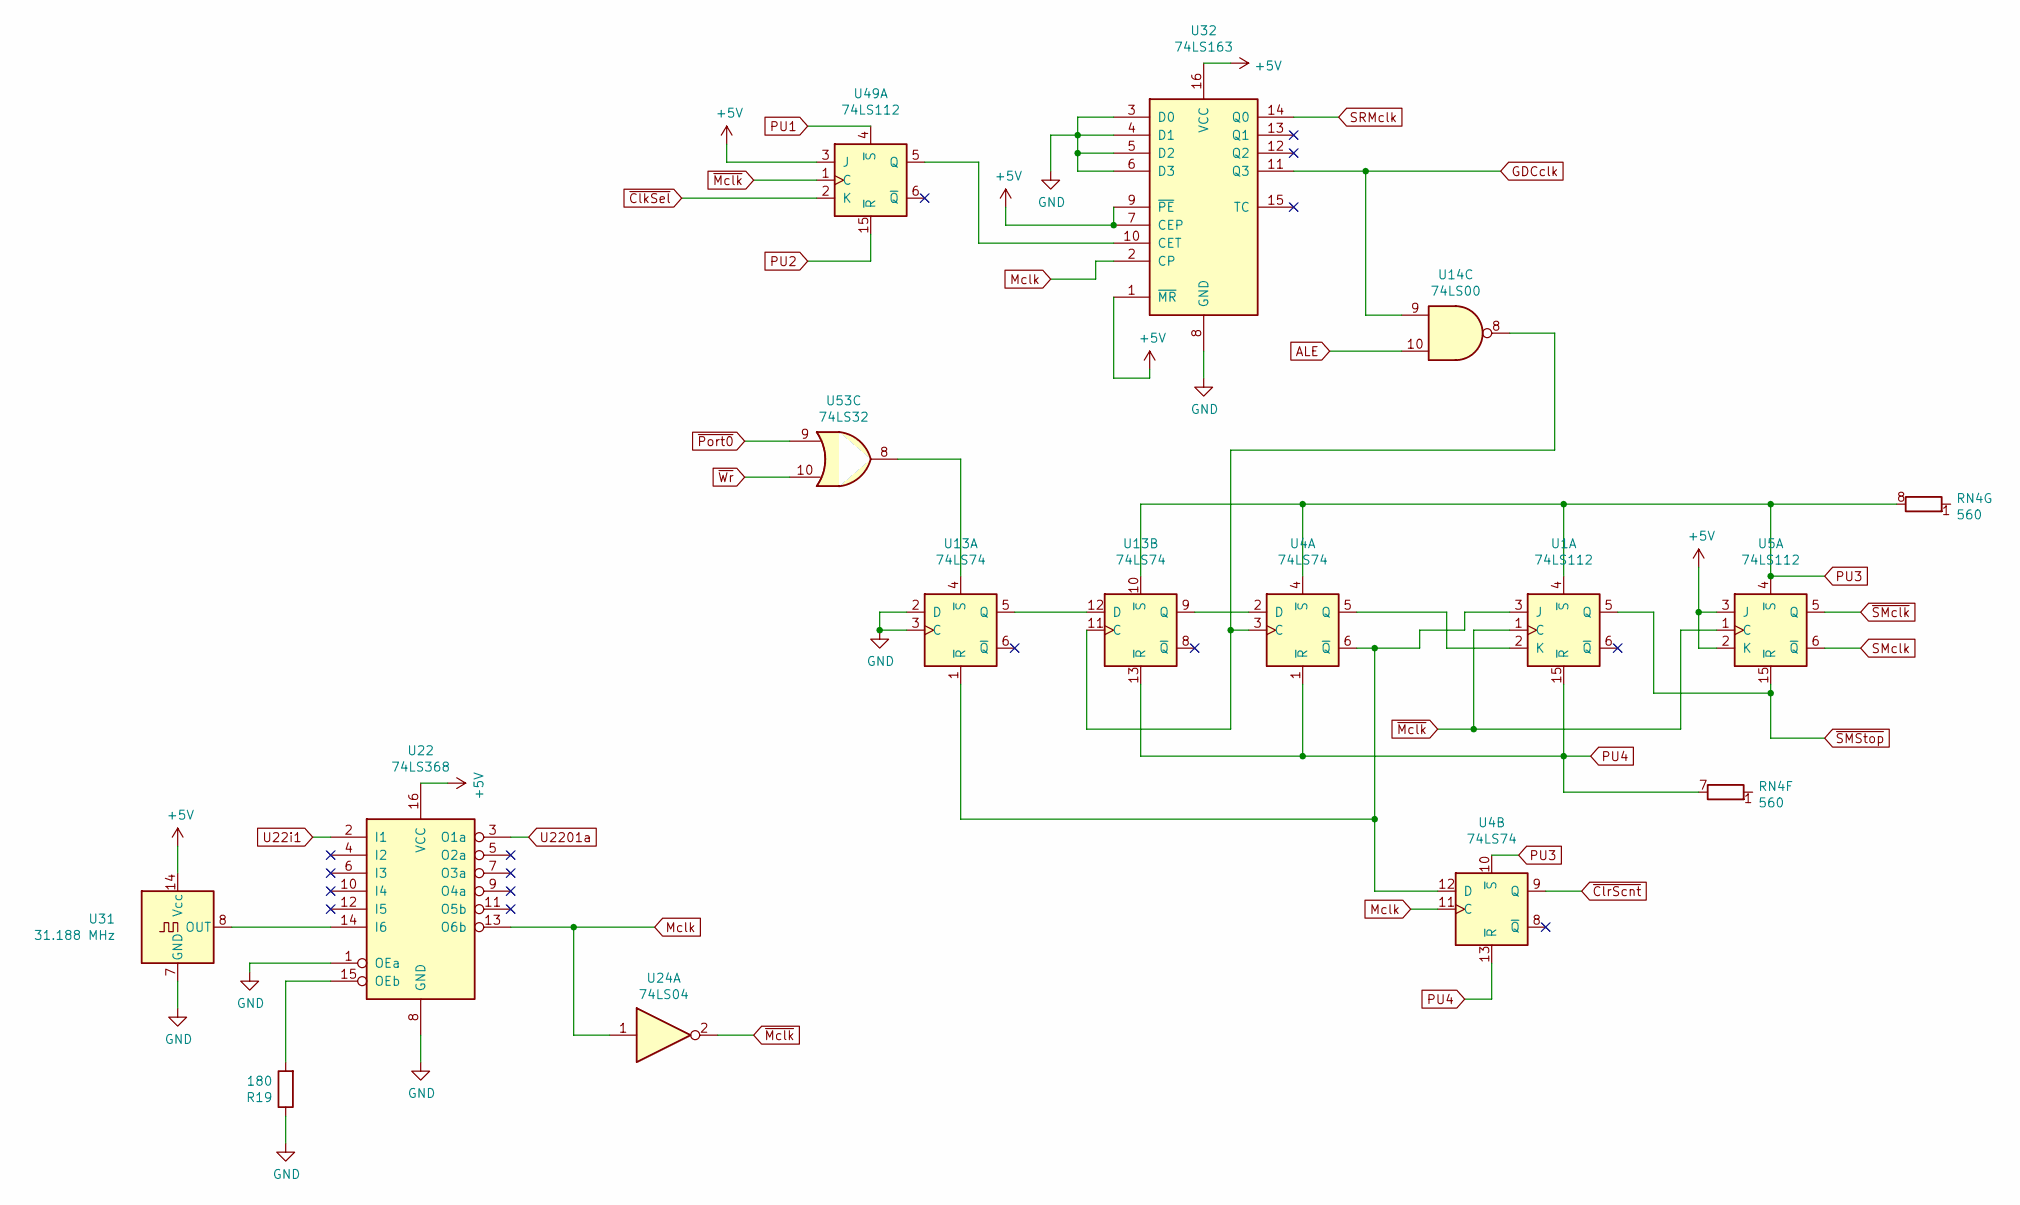
[picture p11: schematic MasterClock.sch]

Parts:
R19: 180; R_Axial_DIN0207_L6.3mm_D2.5mm_P10.16mm_Horizontal
RN4: 560; R_Array_SIP8
U1, U5, U49: 74LS112; DIP-16_W7.62mm
U4, U13: 74LS74; DIP-14_W7.62mm
U14: 74LS00; DIP-14_W7.62mm
U22: 74LS368; DIP-16_W7.62mm
U24: 74LS04; DIP-14_W7.62mm
U31: 31.188 MHz; Oscillator_DIP-14
U32: 74LS163; DIP-16_W7.62mm
U53: 74LS32; DIP-14_W7.62mm

Connections:
+5V: U5.2 (K), U5.3 (J), U22.16 (VCC), U31.14 (Vcc), U32.1 (~MR), U32.7 (CEP), U32.9 (~PE), U32.16 (VCC), U49.3 (J)
ALE: U14.10
GDCclk: U14.9, U32.11 (Q3)
GND: R19.1, U13.2 (D), U13.3 (C), U22.1 (OEa), U22.8 (GND), U31.7 (GND), U32.3 (D0), U32.4 (D1), U32.5 (D2), U32.6 (D3), U32.8 (GND)
Mclk: U4.11 (C), U22.13 (O6b), U24.1, U32.2 (CP)
unnamed: R19.2, U22.15 (OEb)
unnamed: U1.2 (K), U4.5 (Q)
unnamed: U1.3 (J), U4.6 (~Q), U4.12 (D), U13.1 (~R)
unnamed: U13.4 (~S), U53.8
unnamed: U4.2 (D), U13.9 (Q)
unnamed: U4.3 (C), U13.11 (C), U14.8
unnamed: U13.5 (Q), U13.12 (D)
unnamed: U22.14 (I6), U31.8 (OUT)
unnamed: U32.10 (CET), U49.5 (Q)
PU1: U49.4 (~S)
PU2: U49.15 (~R)
PU3: RN4.8 (R7.2), U1.4 (~S), U4.4 (~S), U4.10 (~S), U5.4 (~S), U13.10 (~S)
PU4: RN4.7 (R6.2), U1.15 (~R), U4.1 (~R), U4.13 (~R), U13.13 (~R)
SMclk: U5.6 (~Q)
SRMclk: U32.14 (Q0)
U22i1: U22.2 (I1)
U2201a: U22.3 (O1a)
~ClkSel: U49.2 (K)
~ClrScnt: U4.9 (Q)
~Mclk: U1.1 (C), U5.1 (C), U24.2, U49.1 (C)
~Port0: U53.9
~SMStop: U1.5 (Q), U5.15 (~R)
~SMclk: U5.5 (Q)
~Wr: U53.10
