na103/rainbow100-gs2/kicad/Graphics-V2/Mmu.sch

## KiCad design kicad/Graphics-V2/Mmu.sch (2023-01-17)

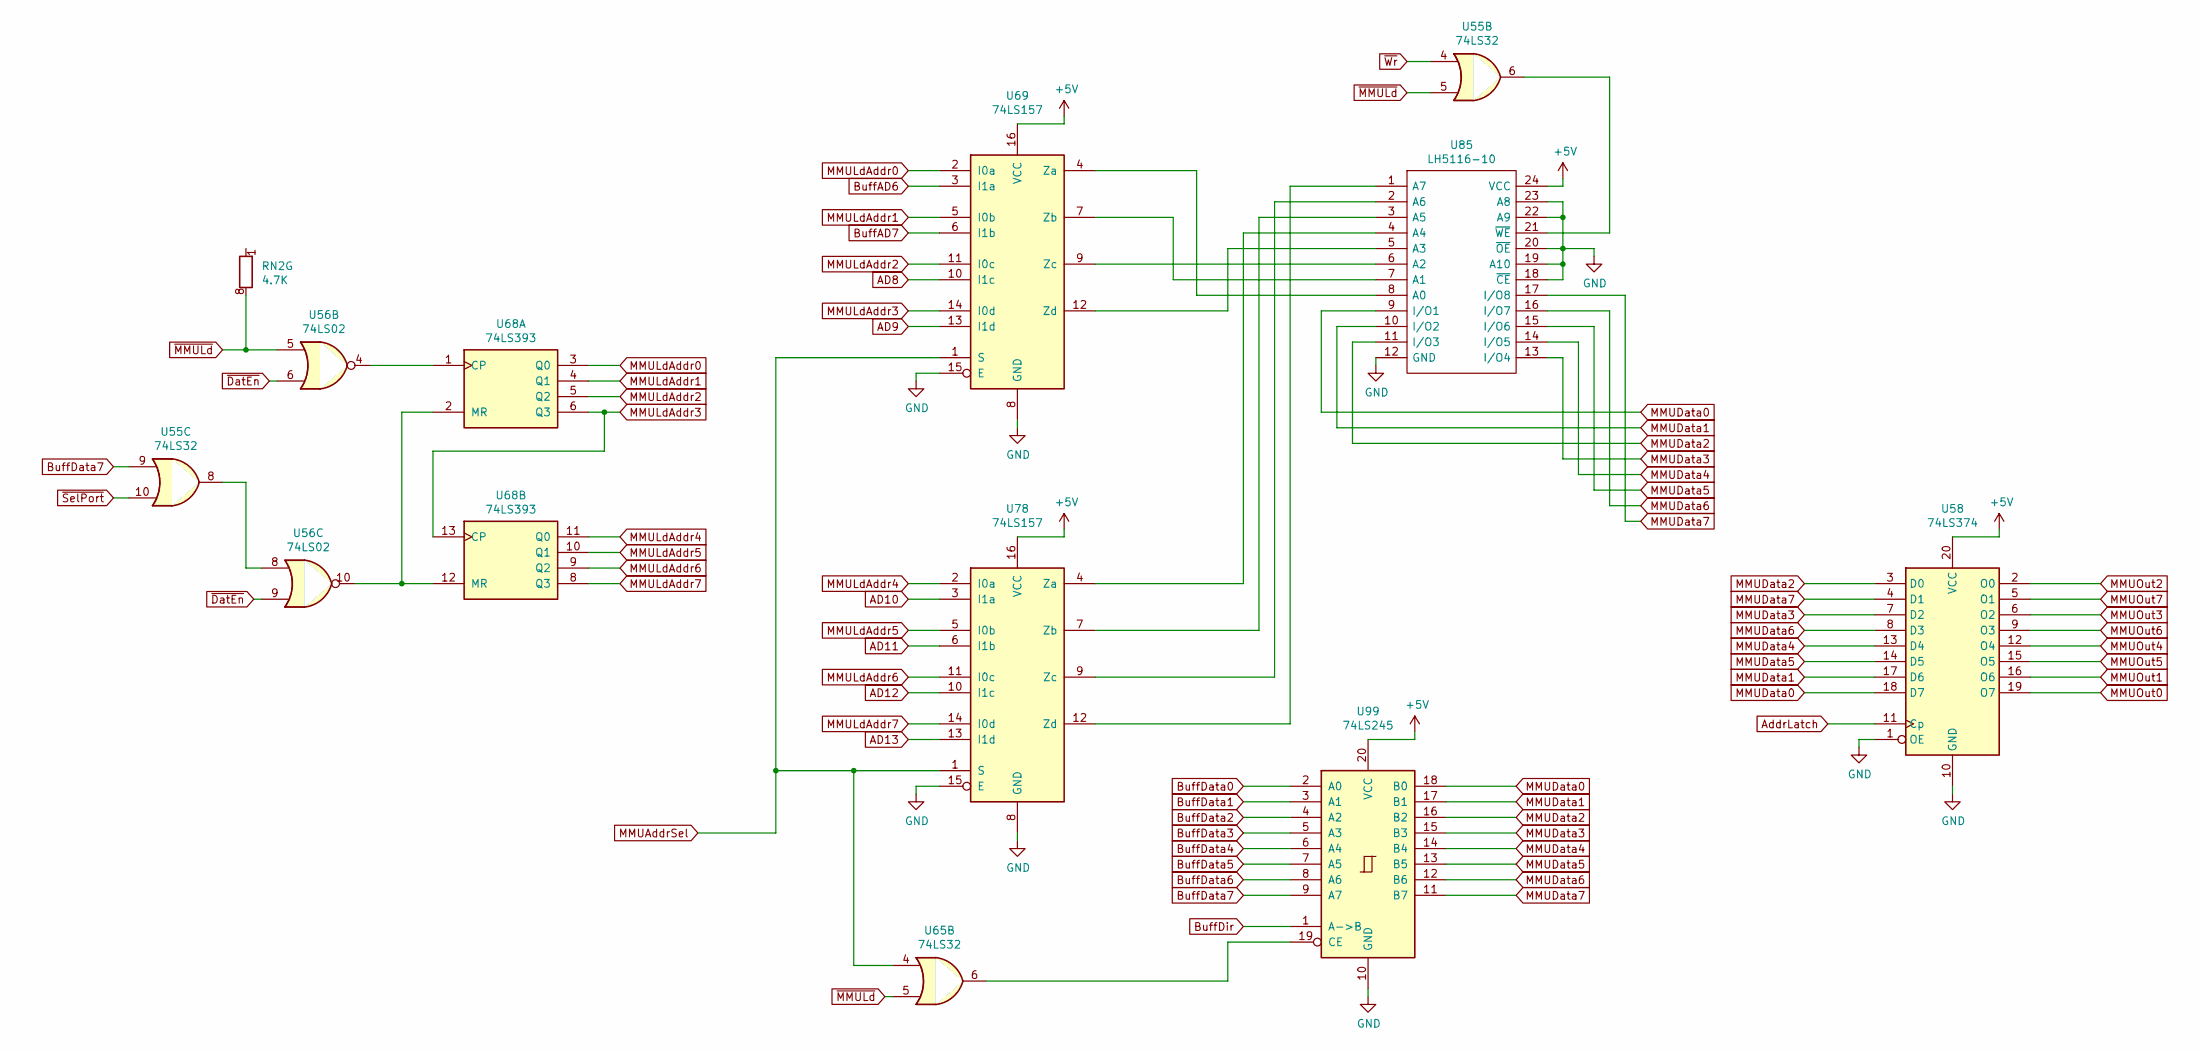
[picture p12: schematic Mmu.sch]

Parts:
RN2: 4.7K; R_Array_SIP8
U55, U65: 74LS32; DIP-14_W7.62mm
U56: 74LS02; DIP-14_W7.62mm
U58: 74LS374; DIP-20_W7.62mm
U68: 74LS393; DIP-14_W7.62mm
U69, U78: 74LS157; DIP-16_W7.62mm
U85: LH5116-10; DIP-24_W15.24mm_Socket; Mouser Part Number N/A
U99: 74LS245; DIP-20_W7.62mm

Connections:
+5V: U58.20 (VCC), U69.16 (VCC), U78.16 (VCC), U85.24 (VCC), U99.20 (VCC)
AD8: U69.10 (I1c)
AD9: U69.13 (I1d)
AD10: U78.3 (I1a)
AD11: U78.6 (I1b)
AD12: U78.10 (I1c)
AD13: U78.13 (I1d)
AddrLatch: U58.11 (Cp)
BuffAD6: U69.3 (I1a)
BuffAD7: U69.6 (I1b)
BuffData0: U99.2 (A0)
BuffData1: U99.3 (A1)
BuffData2: U99.4 (A2)
BuffData3: U99.5 (A3)
BuffData4: U99.6 (A4)
BuffData5: U99.7 (A5)
BuffData6: U99.8 (A6)
BuffData7: U55.9, U99.9 (A7)
BuffDir: U99.1 (A->B)
GND: U58.1 (OE), U58.10 (GND), U69.8 (GND), U69.15 (E), U78.8 (GND), U78.15 (E), U85.12 (GND), U85.18 (~CE), U85.19 (A10), U85.20 (~OE), U85.22 (A9), U85.23 (A8), U99.10 (GND)
MMUAddrSel: U65.4, U69.1 (S), U78.1 (S)
MMUData0: U58.18 (D7), U85.9 (I/O1), U99.18 (B0)
MMUData1: U58.17 (D6), U85.10 (I/O2), U99.17 (B1)
MMUData2: U58.3 (D0), U85.11 (I/O3), U99.16 (B2)
MMUData3: U58.7 (D2), U85.13 (I/O4), U99.15 (B3)
MMUData4: U58.13 (D4), U85.14 (I/O5), U99.14 (B4)
MMUData5: U58.14 (D5), U85.15 (I/O6), U99.13 (B5)
MMUData6: U58.8 (D3), U85.16 (I/O7), U99.12 (B6)
MMUData7: U58.4 (D1), U85.17 (I/O8), U99.11 (B7)
MMULdAddr0: U68.3 (Q0), U69.2 (I0a)
MMULdAddr1: U68.4 (Q1), U69.5 (I0b)
MMULdAddr2: U68.5 (Q2), U69.11 (I0c)
MMULdAddr3: U68.6 (Q3), U68.13 (CP), U69.14 (I0d)
MMULdAddr4: U68.11 (Q0), U78.2 (I0a)
MMULdAddr5: U68.10 (Q1), U78.5 (I0b)
MMULdAddr6: U68.9 (Q2), U78.11 (I0c)
MMULdAddr7: U68.8 (Q3), U78.14 (I0d)
MMUOut0: U58.19 (O7)
MMUOut1: U58.16 (O6)
MMUOut2: U58.2 (O0)
MMUOut3: U58.6 (O2)
MMUOut4: U58.12 (O4)
MMUOut5: U58.15 (O5)
MMUOut6: U58.9 (O3)
MMUOut7: U58.5 (O1)
unnamed: U55.6, U85.21 (~WE)
unnamed: U55.8, U56.8
unnamed: U56.4, U68.1 (CP)
unnamed: U56.10, U68.2 (MR), U68.12 (MR)
unnamed: U65.6, U99.19 (CE)
unnamed: U69.4 (Za), U85.8 (A0)
unnamed: U69.7 (Zb), U85.7 (A1)
unnamed: U69.9 (Zc), U85.6 (A2)
unnamed: U69.12 (Zd), U85.5 (A3)
unnamed: U78.4 (Za), U85.4 (A4)
unnamed: U78.7 (Zb), U85.3 (A5)
unnamed: U78.9 (Zc), U85.2 (A6)
unnamed: U78.12 (Zd), U85.1 (A7)
~DatEn: U56.6, U56.9
~MMULd: RN2.8 (R7.2), U55.5, U56.5, U65.5
~SelPort: U55.10
~Wr: U55.4
