na103/rainbow100-gs2/kicad/Graphics-V2/RAMAddress.sch

## KiCad design kicad/Graphics-V2/RAMAddress.sch (2023-01-17)

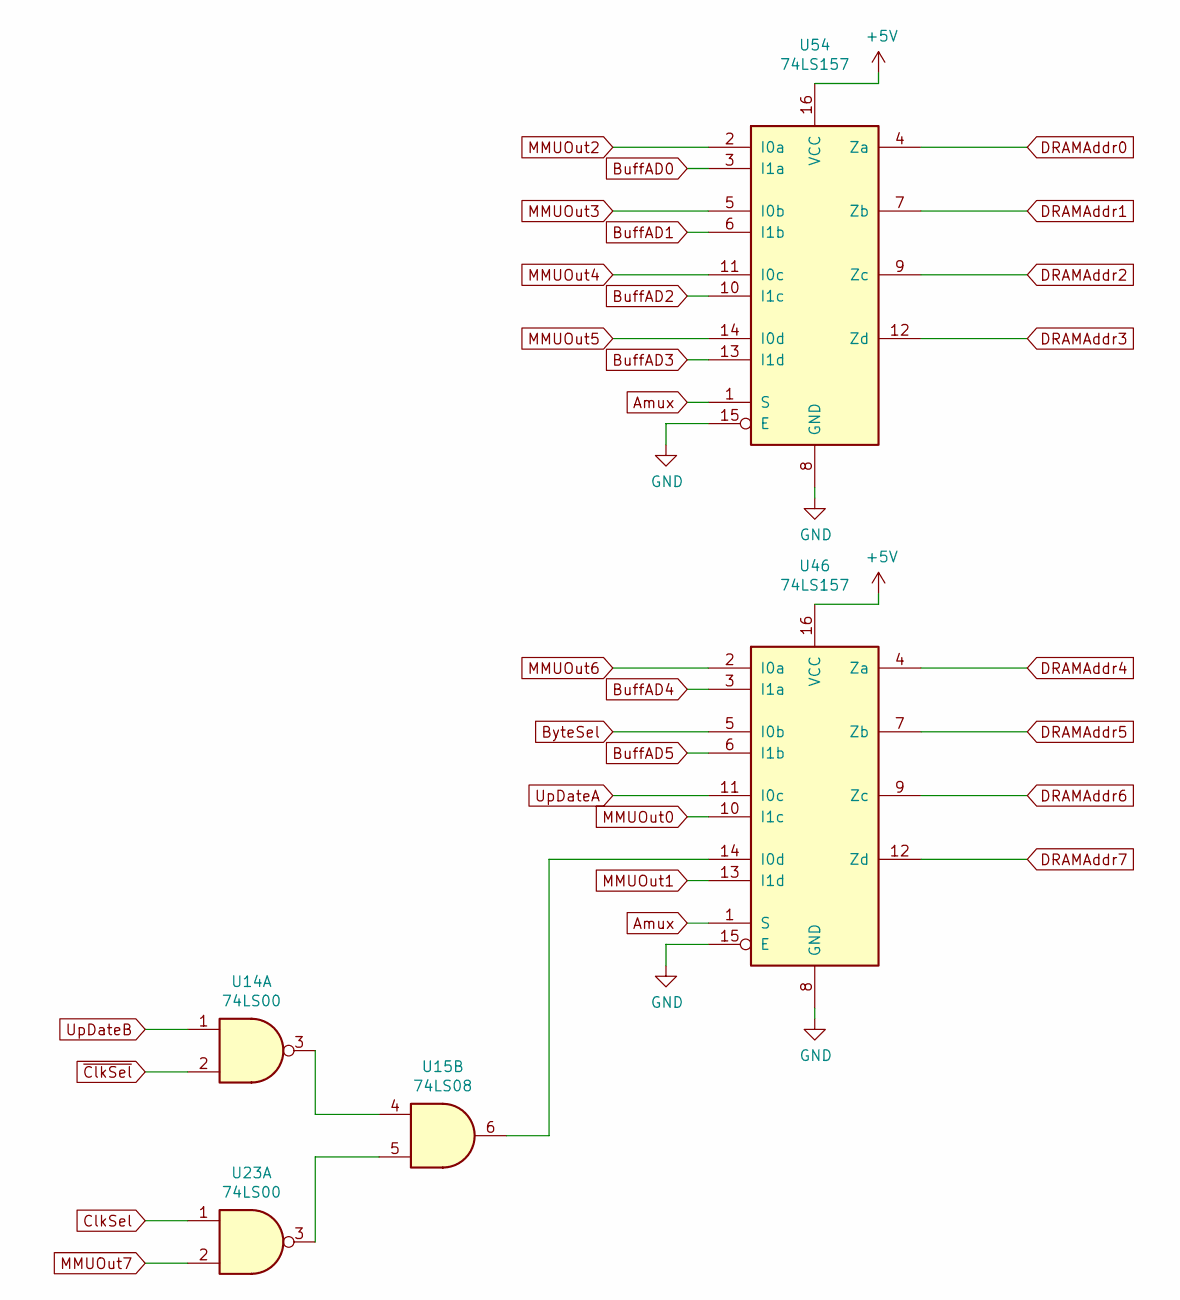
[picture p13: schematic RAMAddress.sch]

Parts:
U14, U23: 74LS00; DIP-14_W7.62mm
U15: 74LS08; DIP-14_W7.62mm
U46, U54: 74LS157; DIP-16_W7.62mm

Connections:
+5V: U46.16 (VCC), U54.16 (VCC)
Amux: U46.1 (S), U54.1 (S)
BuffAD0: U54.3 (I1a)
BuffAD1: U54.6 (I1b)
BuffAD2: U54.10 (I1c)
BuffAD3: U54.13 (I1d)
BuffAD4: U46.3 (I1a)
BuffAD5: U46.6 (I1b)
ByteSel: U46.5 (I0b)
ClkSel: U23.1
DRAMAddr0: U54.4 (Za)
DRAMAddr1: U54.7 (Zb)
DRAMAddr2: U54.9 (Zc)
DRAMAddr3: U54.12 (Zd)
DRAMAddr4: U46.4 (Za)
DRAMAddr5: U46.7 (Zb)
DRAMAddr6: U46.9 (Zc)
DRAMAddr7: U46.12 (Zd)
GND: U46.8 (GND), U46.15 (E), U54.8 (GND), U54.15 (E)
MMUOut0: U46.10 (I1c)
MMUOut1: U46.13 (I1d)
MMUOut2: U54.2 (I0a)
MMUOut3: U54.5 (I0b)
MMUOut4: U54.11 (I0c)
MMUOut5: U54.14 (I0d)
MMUOut6: U46.2 (I0a)
MMUOut7: U23.2
unnamed: U14.3, U15.4
unnamed: U15.5, U23.3
unnamed: U15.6, U46.14 (I0d)
UpDateA: U46.11 (I0c)
UpDateB: U14.1
~ClkSel: U14.2
