na103/rainbow100-gs2/kicad/Graphics-V2/RamWriteOut.sch

## KiCad design kicad/Graphics-V2/RamWriteOut.sch (2023-01-17)

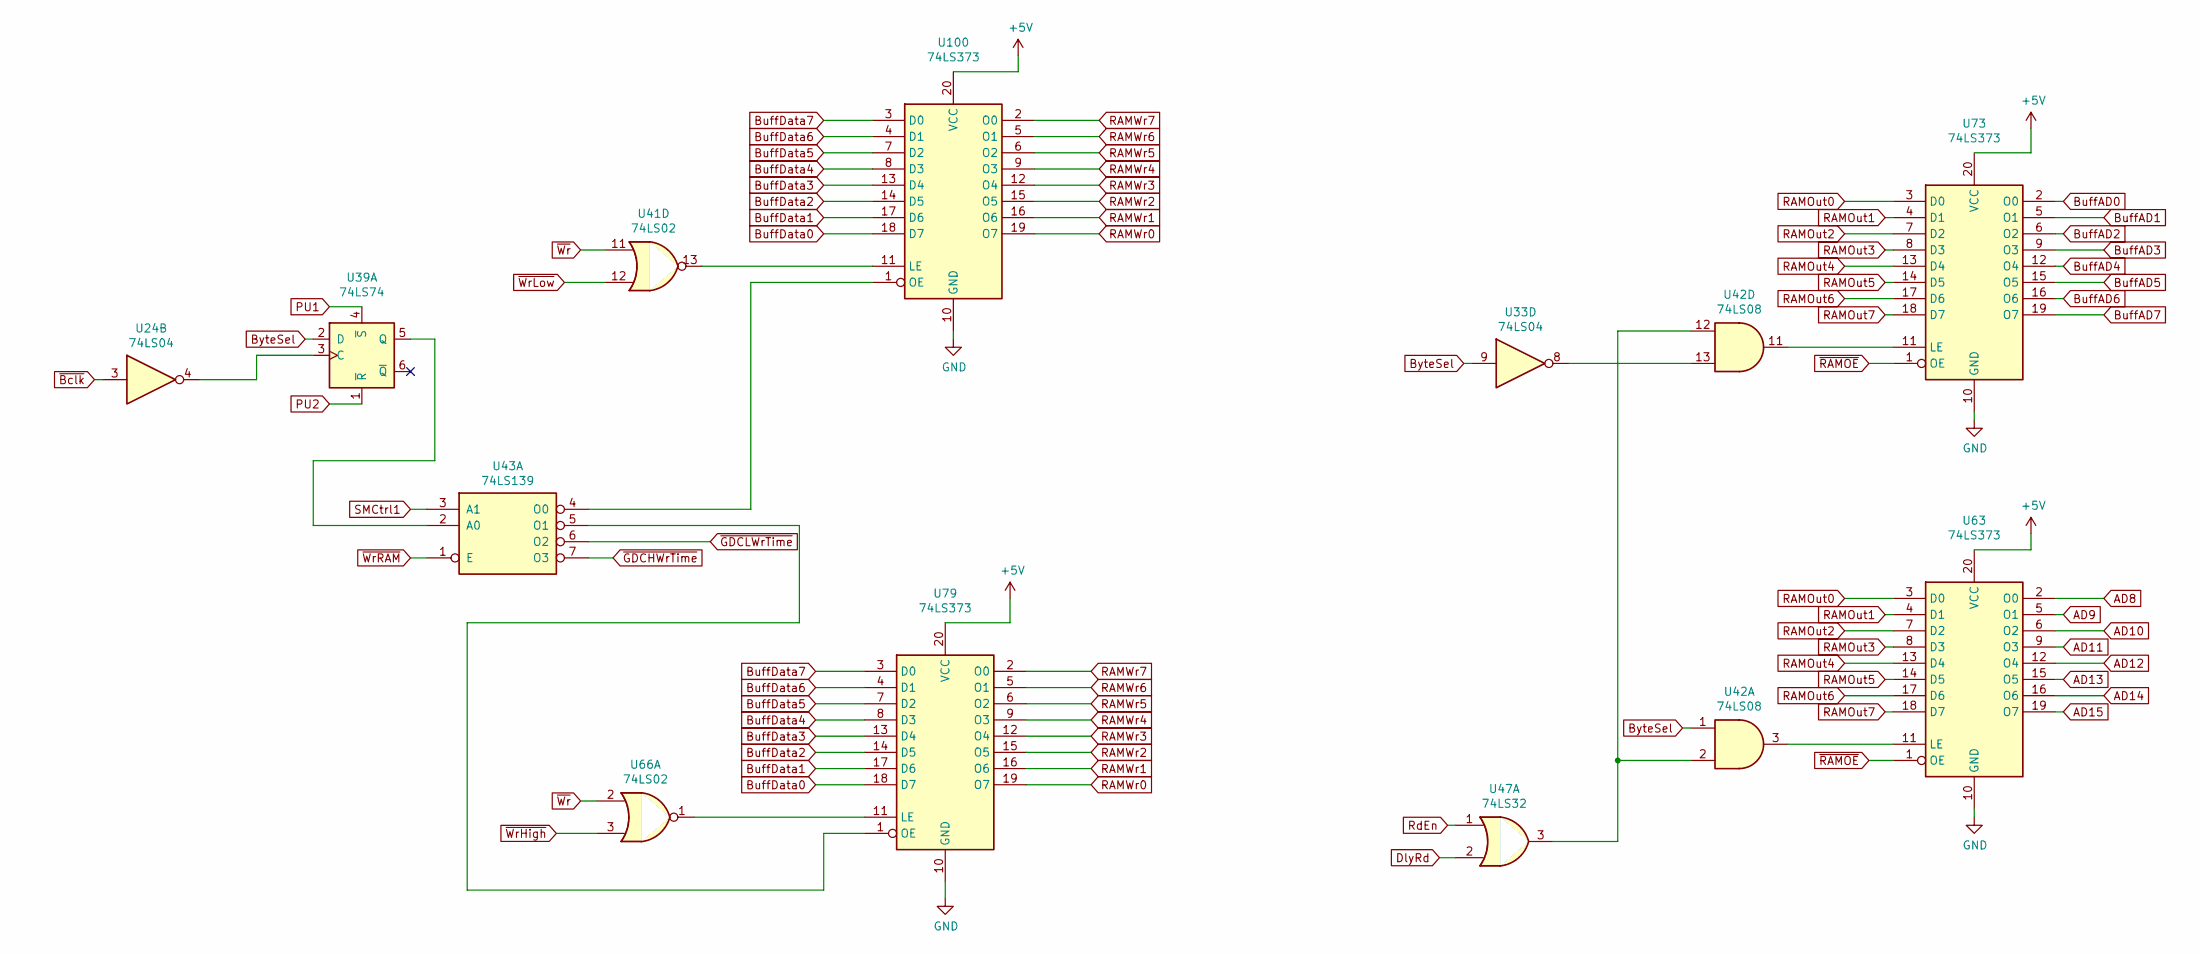
[picture p14: schematic RamWriteOut.sch]

Parts:
U24, U33: 74LS04; DIP-14_W7.62mm
U39: 74LS74; DIP-14_W7.62mm
U41, U66: 74LS02; DIP-14_W7.62mm
U42: 74LS08; DIP-14_W7.62mm
U43: 74LS139; DIP-16_W7.62mm
U47: 74LS32; DIP-14_W7.62mm
U63, U73, U79, U100: 74LS373; DIP-20_W7.62mm

Connections:
+5V: U63.20 (VCC), U73.20 (VCC), U79.20 (VCC), U100.20 (VCC)
AD8: U63.2 (O0)
AD9: U63.5 (O1)
AD10: U63.6 (O2)
AD11: U63.9 (O3)
AD12: U63.12 (O4)
AD13: U63.15 (O5)
AD14: U63.16 (O6)
AD15: U63.19 (O7)
BuffAD0: U73.2 (O0)
BuffAD1: U73.5 (O1)
BuffAD2: U73.6 (O2)
BuffAD3: U73.9 (O3)
BuffAD4: U73.12 (O4)
BuffAD5: U73.15 (O5)
BuffAD6: U73.16 (O6)
BuffAD7: U73.19 (O7)
BuffData0: U79.18 (D7), U100.18 (D7)
BuffData1: U79.17 (D6), U100.17 (D6)
BuffData2: U79.14 (D5), U100.14 (D5)
BuffData3: U79.13 (D4), U100.13 (D4)
BuffData4: U79.8 (D3), U100.8 (D3)
BuffData5: U79.7 (D2), U100.7 (D2)
BuffData6: U79.4 (D1), U100.4 (D1)
BuffData7: U79.3 (D0), U100.3 (D0)
ByteSel: U33.9, U39.2 (D), U42.1
DlyRd: U47.2
GND: U63.10 (GND), U73.10 (GND), U79.10 (GND), U100.10 (GND)
unnamed: U24.4, U39.3 (C)
unnamed: U33.8, U42.13
unnamed: U39.5 (Q), U43.2 (A0)
unnamed: U42.3, U63.11 (LE)
unnamed: U42.11, U73.11 (LE)
unnamed: U42.2, U42.12, U47.3
unnamed: U43.5 (O1), U79.1 (OE)
unnamed: U66.1, U79.11 (LE)
unnamed: U43.4 (O0), U100.1 (OE)
unnamed: U41.13, U100.11 (LE)
PU1: U39.4 (~S)
PU2: U39.1 (~R)
RAMOut0: U63.3 (D0), U73.3 (D0)
RAMOut1: U63.4 (D1), U73.4 (D1)
RAMOut2: U63.7 (D2), U73.7 (D2)
RAMOut3: U63.8 (D3), U73.8 (D3)
RAMOut4: U63.13 (D4), U73.13 (D4)
RAMOut5: U63.14 (D5), U73.14 (D5)
RAMOut6: U63.17 (D6), U73.17 (D6)
RAMOut7: U63.18 (D7), U73.18 (D7)
RAMWr0: U79.19 (O7), U100.19 (O7)
RAMWr1: U79.16 (O6), U100.16 (O6)
RAMWr2: U79.15 (O5), U100.15 (O5)
RAMWr3: U79.12 (O4), U100.12 (O4)
RAMWr4: U79.9 (O3), U100.9 (O3)
RAMWr5: U79.6 (O2), U100.6 (O2)
RAMWr6: U79.5 (O1), U100.5 (O1)
RAMWr7: U79.2 (O0), U100.2 (O0)
RdEn: U47.1
SMCtrl1: U43.3 (A1)
~Bclk: U24.3
~GDCHWrTime: U43.7 (O3)
~GDCLWrTime: U43.6 (O2)
~RAMOE: U63.1 (OE), U73.1 (OE)
~Wr: U41.11, U66.2
~WrHigh: U66.3
~WrLow: U41.12
~WrRAM: U43.1 (E)
