na103/rainbow100-gs2/kicad/Graphics-V2/UpdateBuffer.sch

## KiCad design kicad/Graphics-V2/UpdateBuffer.sch (2023-01-17)

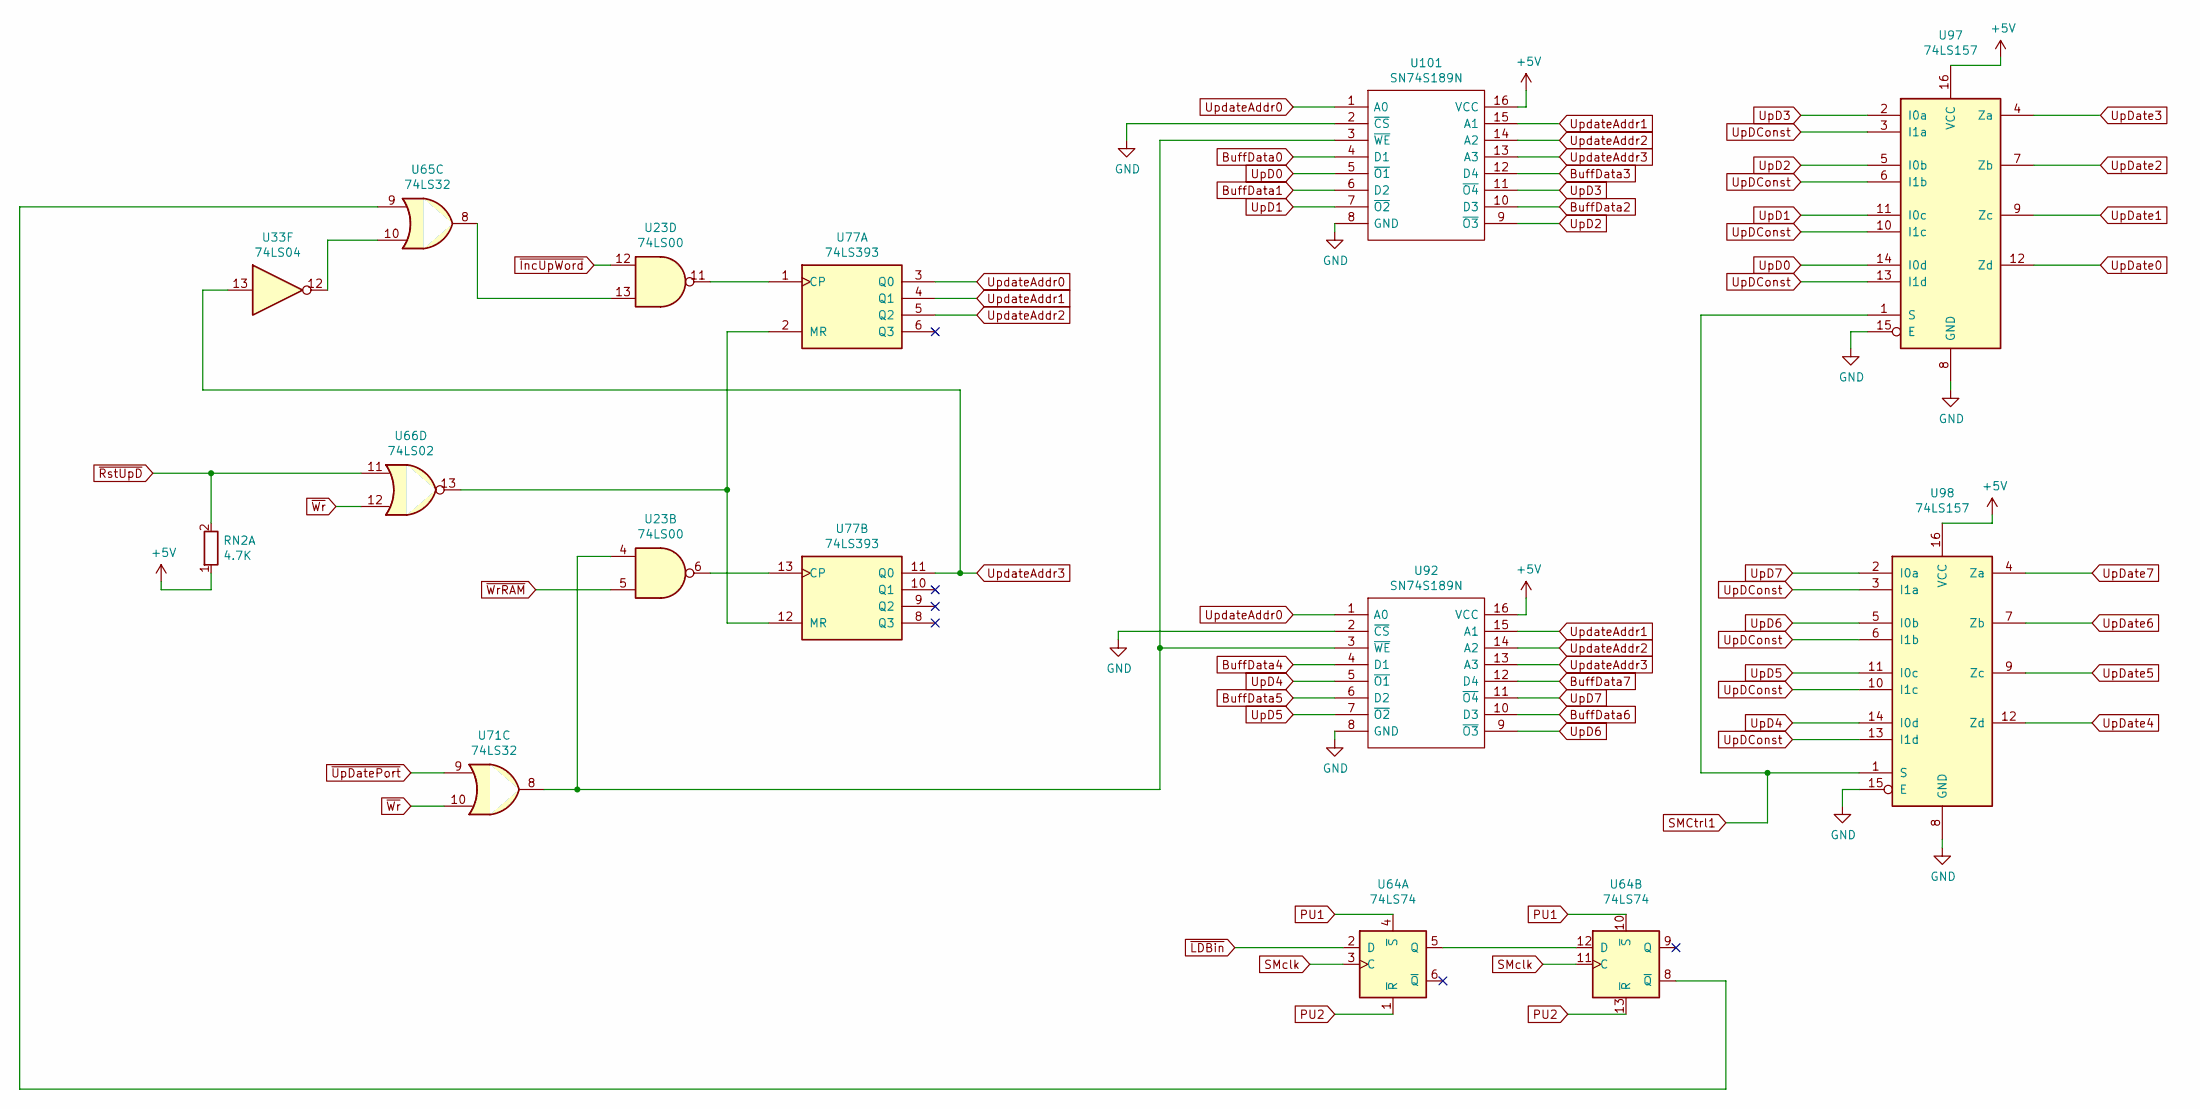
[picture p15: schematic UpdateBuffer.sch]

Parts:
RN2: 4.7K; R_Array_SIP8
U23: 74LS00; DIP-14_W7.62mm
U33: 74LS04; DIP-14_W7.62mm
U64: 74LS74; DIP-14_W7.62mm
U65, U71: 74LS32; DIP-14_W7.62mm
U66: 74LS02; DIP-14_W7.62mm
U77: 74LS393; DIP-14_W7.62mm
U92, U101: SN74S189N; DIP-16_W7.62mm_Socket; Manufacturer_Part_Number SN74S189N
U97, U98: 74LS157; DIP-16_W7.62mm

Connections:
+5V: RN2.1 (R1.1), U92.16 (VCC), U97.16 (VCC), U98.16 (VCC), U101.16 (VCC)
BuffData0: U101.4 (D1)
BuffData1: U101.6 (D2)
BuffData2: U101.10 (D3)
BuffData3: U101.12 (D4)
BuffData4: U92.4 (D1)
BuffData5: U92.6 (D2)
BuffData6: U92.10 (D3)
BuffData7: U92.12 (D4)
GND: U92.2 (~CS), U92.8 (GND), U97.8 (GND), U97.15 (E), U98.8 (GND), U98.15 (E), U101.2 (~CS), U101.8 (GND)
unnamed: U23.6, U77.13 (CP)
unnamed: U23.11, U77.1 (CP)
unnamed: U23.13, U65.8
unnamed: U33.12, U65.10
unnamed: U64.8 (~Q), U65.9
unnamed: U64.5 (Q), U64.12 (D)
unnamed: U66.13, U77.2 (MR), U77.12 (MR)
unnamed: U23.4, U71.8, U92.3 (~WE), U101.3 (~WE)
PU1: U64.4 (~S), U64.10 (~S)
PU2: U64.1 (~R), U64.13 (~R)
SMCtrl1: U97.1 (S), U98.1 (S)
SMclk: U64.3 (C), U64.11 (C)
UpD0: U97.14 (I0d), U101.5 (~O1)
UpD1: U97.11 (I0c), U101.7 (~O2)
UpD2: U97.5 (I0b), U101.9 (~O3)
UpD3: U97.2 (I0a), U101.11 (~O4)
UpD4: U92.5 (~O1), U98.14 (I0d)
UpD5: U92.7 (~O2), U98.11 (I0c)
UpD6: U92.9 (~O3), U98.5 (I0b)
UpD7: U92.11 (~O4), U98.2 (I0a)
UpDConst: U97.3 (I1a), U97.6 (I1b), U97.10 (I1c), U97.13 (I1d), U98.3 (I1a), U98.6 (I1b), U98.10 (I1c), U98.13 (I1d)
UpDate0: U97.12 (Zd)
UpDate1: U97.9 (Zc)
UpDate2: U97.7 (Zb)
UpDate3: U97.4 (Za)
UpDate4: U98.12 (Zd)
UpDate5: U98.9 (Zc)
UpDate6: U98.7 (Zb)
UpDate7: U98.4 (Za)
UpdateAddr0: U77.3 (Q0), U92.1 (A0), U101.1 (A0)
UpdateAddr1: U77.4 (Q1), U92.15 (A1), U101.15 (A1)
UpdateAddr2: U77.5 (Q2), U92.14 (A2), U101.14 (A2)
UpdateAddr3: U33.13, U77.11 (Q0), U92.13 (A3), U101.13 (A3)
~IncUpWord: U23.12
~LDBin: U64.2 (D)
~RstUpD: RN2.2 (R1.2), U66.11
~UpDatePort: U71.9
~Wr: U66.12, U71.10
~WrRAM: U23.5
