na103/rainbow100-gs2/kicad/Graphics-V2/UpdateConstants.sch

## KiCad design kicad/Graphics-V2/UpdateConstants.sch (2023-01-17)

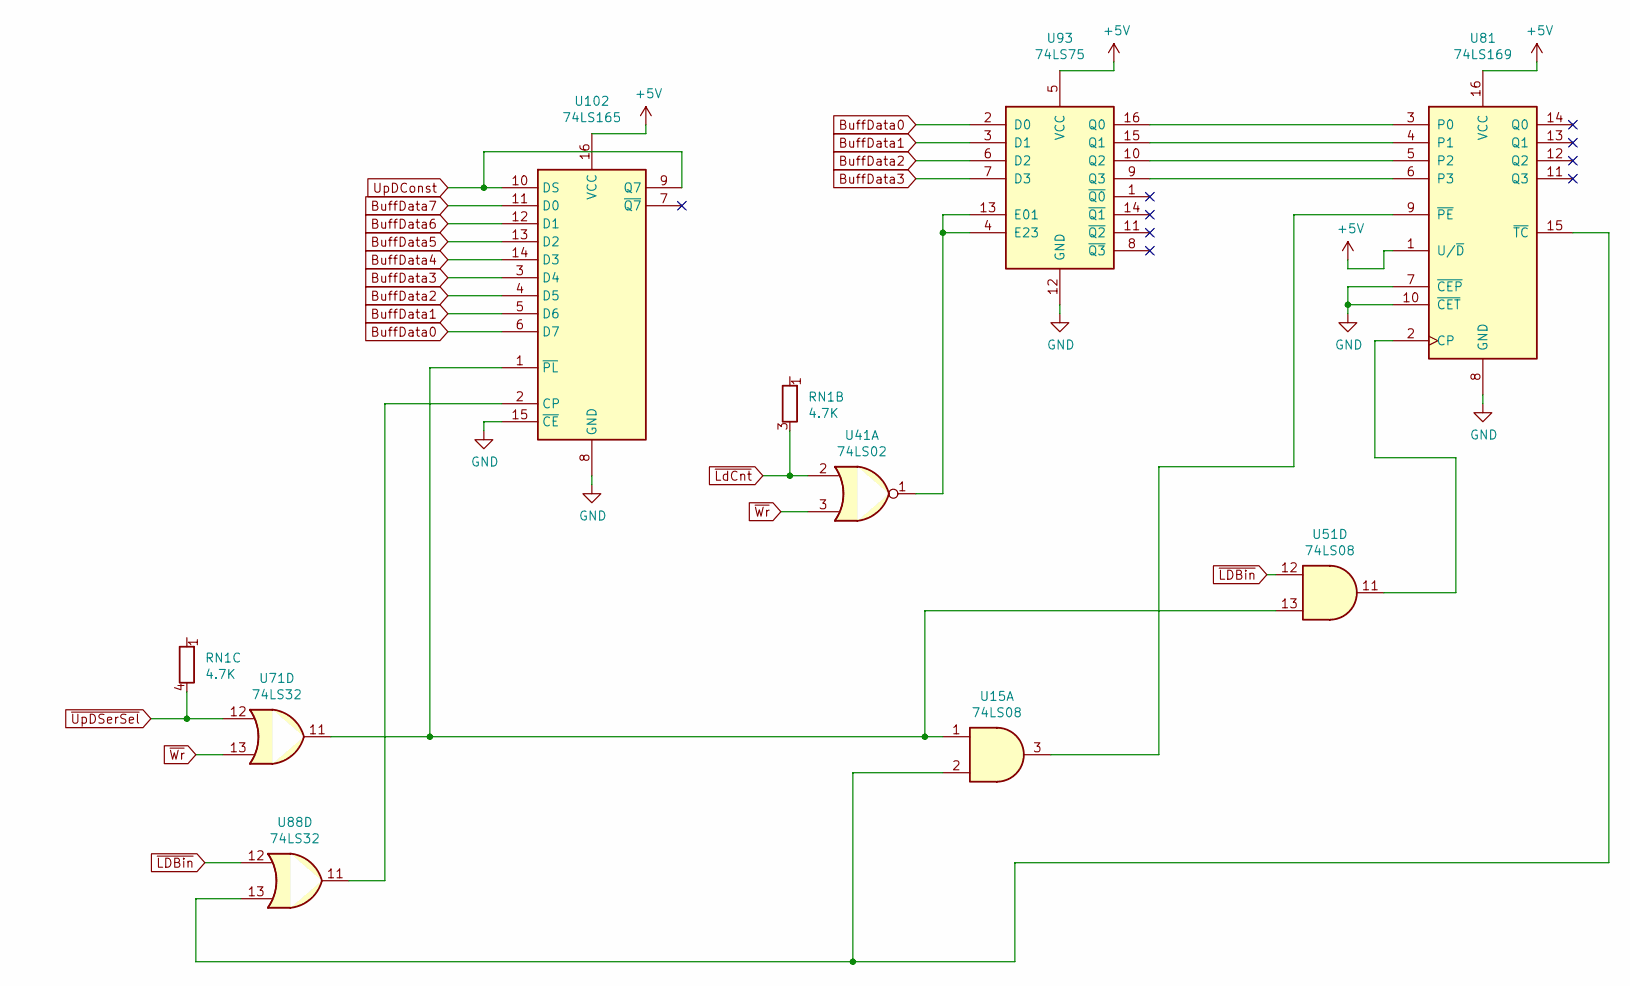
[picture p16: schematic UpdateConstants.sch]

Parts:
RN1: 4.7K; R_Array_SIP8
U15, U51: 74LS08; DIP-14_W7.62mm
U41: 74LS02; DIP-14_W7.62mm
U71, U88: 74LS32; DIP-14_W7.62mm
U81: 74LS169; DIP-16_W7.62mm
U93: 74LS75; DIP-16_W7.62mm
U102: 74LS165; DIP-16_W7.62mm

Connections:
+5V: U81.1 (U/~D), U81.16 (VCC), U93.5 (VCC), U102.16 (VCC)
BuffData0: U93.2 (D0), U102.6 (D7)
BuffData1: U93.3 (D1), U102.5 (D6)
BuffData2: U93.6 (D2), U102.4 (D5)
BuffData3: U93.7 (D3), U102.3 (D4)
BuffData4: U102.14 (D3)
BuffData5: U102.13 (D2)
BuffData6: U102.12 (D1)
BuffData7: U102.11 (D0)
GND: U81.7 (~CEP), U81.8 (GND), U81.10 (~CET), U93.12 (GND), U102.8 (GND), U102.15 (~CE)
unnamed: U15.2, U81.15 (~TC), U88.13
unnamed: U15.3, U81.9 (~PE)
unnamed: U41.1, U93.4 (E23), U93.13 (E01)
unnamed: U51.11, U81.2 (CP)
unnamed: U81.3 (P0), U93.16 (Q0)
unnamed: U81.4 (P1), U93.15 (Q1)
unnamed: U81.5 (P2), U93.10 (Q2)
unnamed: U81.6 (P3), U93.9 (Q3)
unnamed: U15.1, U51.13, U71.11, U102.1 (~PL)
unnamed: U88.11, U102.2 (CP)
UpDConst: U102.9 (Q7), U102.10 (DS)
~LDBin: U51.12, U88.12
~LdCnt: RN1.3 (R2.2), U41.2
~UpDSerSel: RN1.4 (R3.2), U71.12
~Wr: U41.3, U71.13
