na103/rainbow100-gs2/kicad/Graphics-V2/VideoOutput.sch

## KiCad design kicad/Graphics-V2/VideoOutput.sch (2023-01-17)

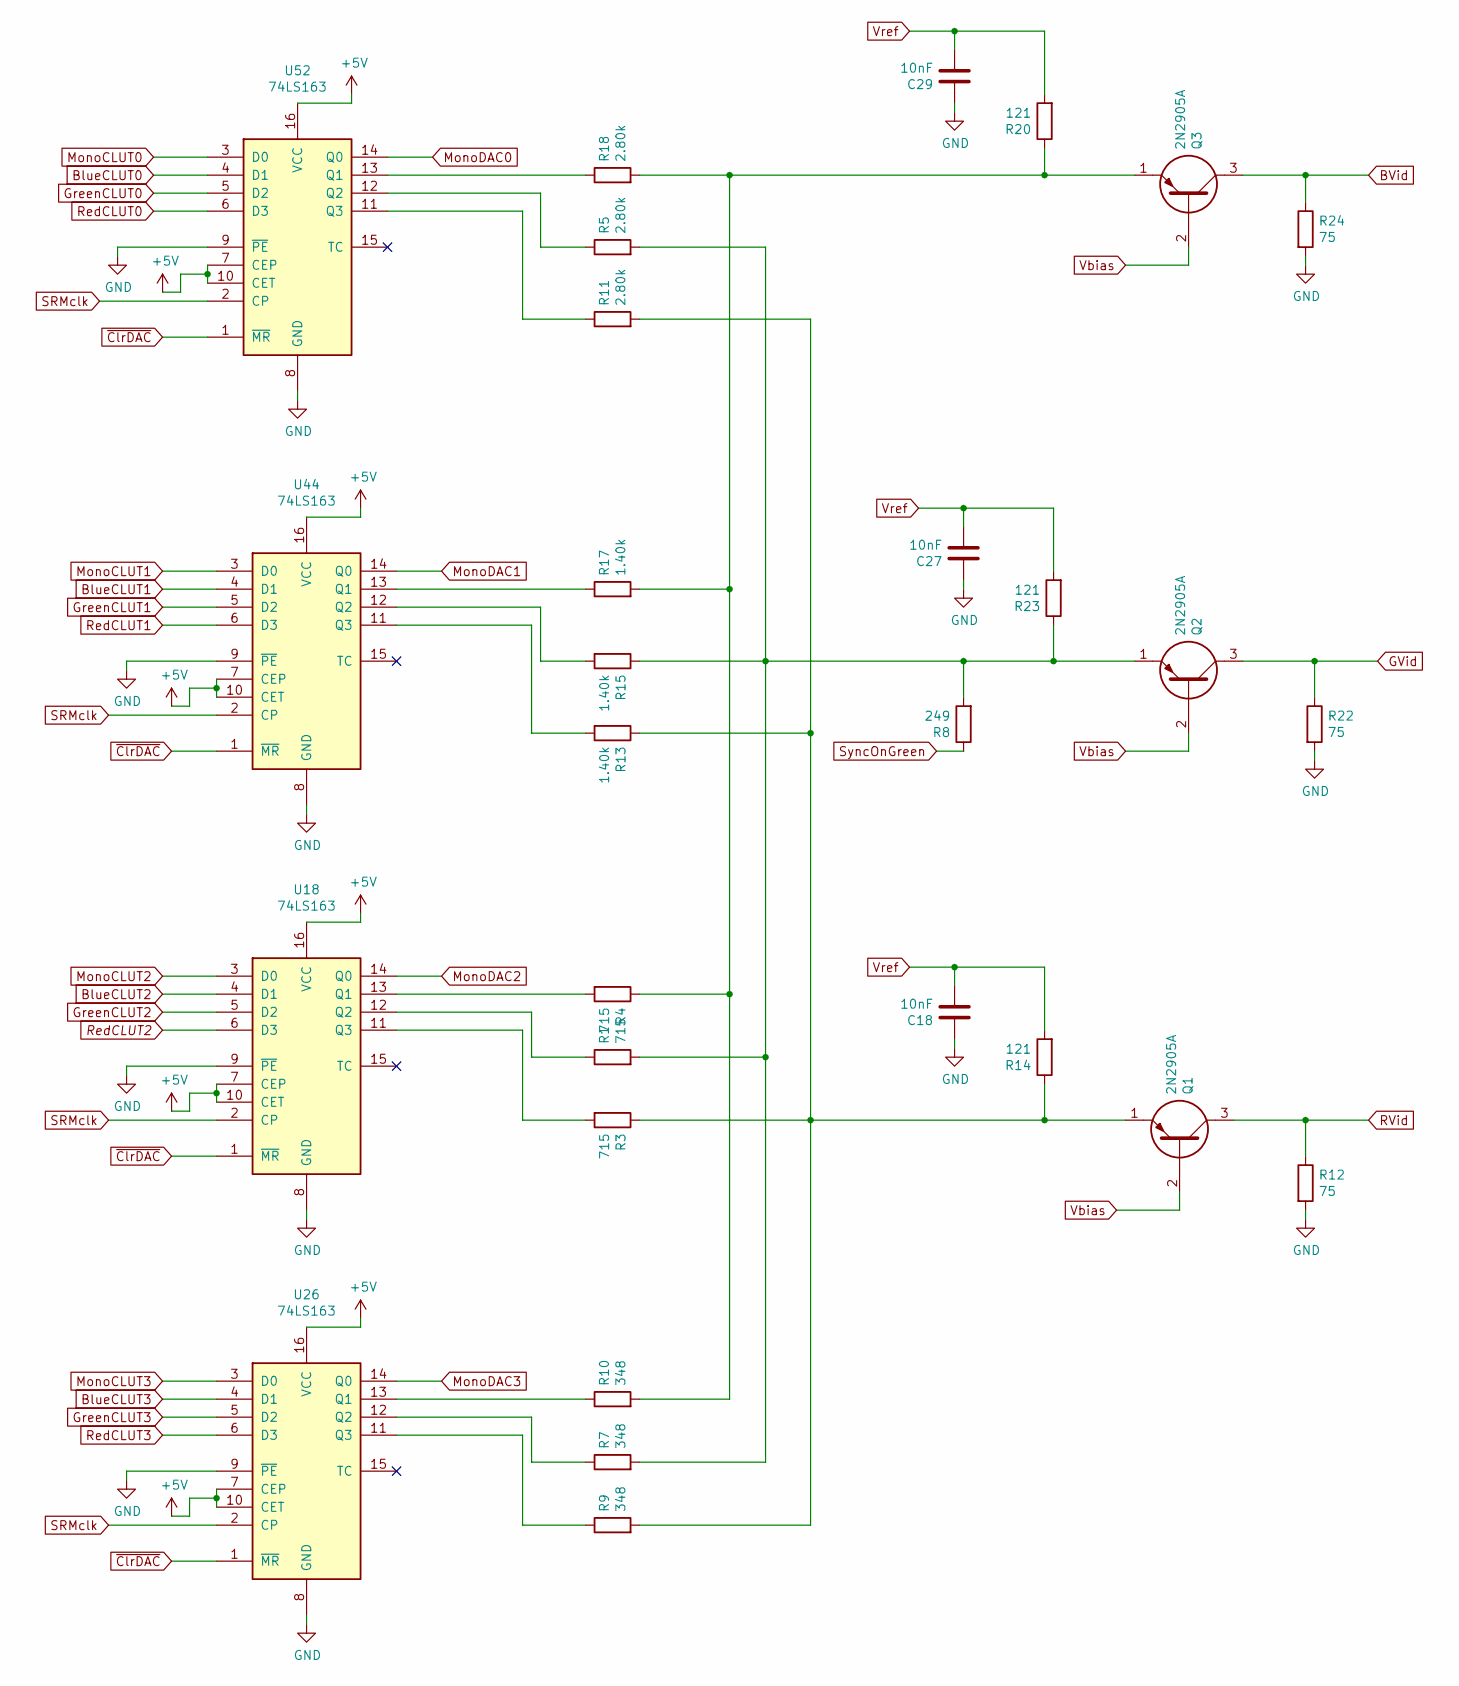
[picture p17: schematic VideoOutput.sch]

Parts:
C18, C27, C29: 10nF; C_Axial_L3.8mm_D2.6mm_P10.00mm_Horizontal
Q1, Q2, Q3: 2N2905A; TO-39-3; Manufacturer_Part_Number 2N2905A PBFREE; Mouser Part Number 610-2N2905A
R1, R3, R4: 715; R_Axial_DIN0207_L6.3mm_D2.5mm_P10.16mm_Horizontal
R5, R11, R18: 2.80k; R_Axial_DIN0207_L6.3mm_D2.5mm_P10.16mm_Horizontal
R7, R9, R10: 348; R_Axial_DIN0207_L6.3mm_D2.5mm_P10.16mm_Horizontal
R8: 249; R_Axial_DIN0207_L6.3mm_D2.5mm_P10.16mm_Horizontal
R12, R22, R24: 75; R_Axial_DIN0207_L6.3mm_D2.5mm_P10.16mm_Horizontal
R13, R15, R17: 1.40k; R_Axial_DIN0207_L6.3mm_D2.5mm_P10.16mm_Horizontal
R14, R20, R23: 121; R_Axial_DIN0207_L6.3mm_D2.5mm_P10.16mm_Horizontal
U18, U26, U44, U52: 74LS163; DIP-16_W7.62mm

Connections:
+5V: U18.7 (CEP), U18.10 (CET), U18.16 (VCC), U26.7 (CEP), U26.10 (CET), U26.16 (VCC), U44.7 (CEP), U44.10 (CET), U44.16 (VCC), U52.7 (CEP), U52.10 (CET), U52.16 (VCC)
BVid: Q3.3, R24.1
BlueCLUT0: U52.4 (D1)
BlueCLUT1: U44.4 (D1)
BlueCLUT2: U18.4 (D1)
BlueCLUT3: U26.4 (D1)
GND: C18.1, C27.1, C29.1, R12.2, R22.2, R24.2, U18.8 (GND), U18.9 (~PE), U26.8 (GND), U26.9 (~PE), U44.8 (GND), U44.9 (~PE), U52.8 (GND), U52.9 (~PE)
GVid: Q2.3, R22.1
GreenCLUT0: U52.5 (D2)
GreenCLUT1: U44.5 (D2)
GreenCLUT2: U18.5 (D2)
GreenCLUT3: U26.5 (D2)
MonoCLUT0: U52.3 (D0)
MonoCLUT1: U44.3 (D0)
MonoCLUT2: U18.3 (D0)
MonoCLUT3: U26.3 (D0)
MonoDAC0: U52.14 (Q0)
MonoDAC1: U44.14 (Q0)
MonoDAC2: U18.14 (Q0)
MonoDAC3: U26.14 (Q0)
unnamed: Q1.1, R3.1, R9.2, R11.2, R13.1, R14.1
unnamed: Q2.1, R1.2, R5.2, R7.2, R8.2, R15.1, R23.1
unnamed: Q3.1, R4.1, R10.2, R17.2, R18.2, R20.1
unnamed: R1.1, U18.12 (Q2)
unnamed: R3.2, U18.11 (Q3)
unnamed: R4.2, U18.13 (Q1)
unnamed: R5.1, U52.12 (Q2)
unnamed: R7.1, U26.12 (Q2)
unnamed: R9.1, U26.11 (Q3)
unnamed: R10.1, U26.13 (Q1)
unnamed: R11.1, U52.11 (Q3)
unnamed: R13.2, U44.11 (Q3)
unnamed: R15.2, U44.12 (Q2)
unnamed: R17.1, U44.13 (Q1)
unnamed: R18.1, U52.13 (Q1)
RVid: Q1.3, R12.1
RedCLUT0: U52.6 (D3)
RedCLUT1: U44.6 (D3)
RedCLUT2: U18.6 (D3)
RedCLUT3: U26.6 (D3)
SRMclk: U18.2 (CP), U26.2 (CP), U44.2 (CP), U52.2 (CP)
SyncOnGreen: R8.1
Vbias: Q1.2, Q2.2, Q3.2
Vref: C18.2, C27.2, C29.2, R14.2, R20.2, R23.2
~ClrDAC: U18.1 (~MR), U26.1 (~MR), U44.1 (~MR), U52.1 (~MR)
