na103/rainbow100-gs2/kicad/Graphics-V2/VideoRAM.sch

## KiCad design kicad/Graphics-V2/VideoRAM.sch (2023-01-17)

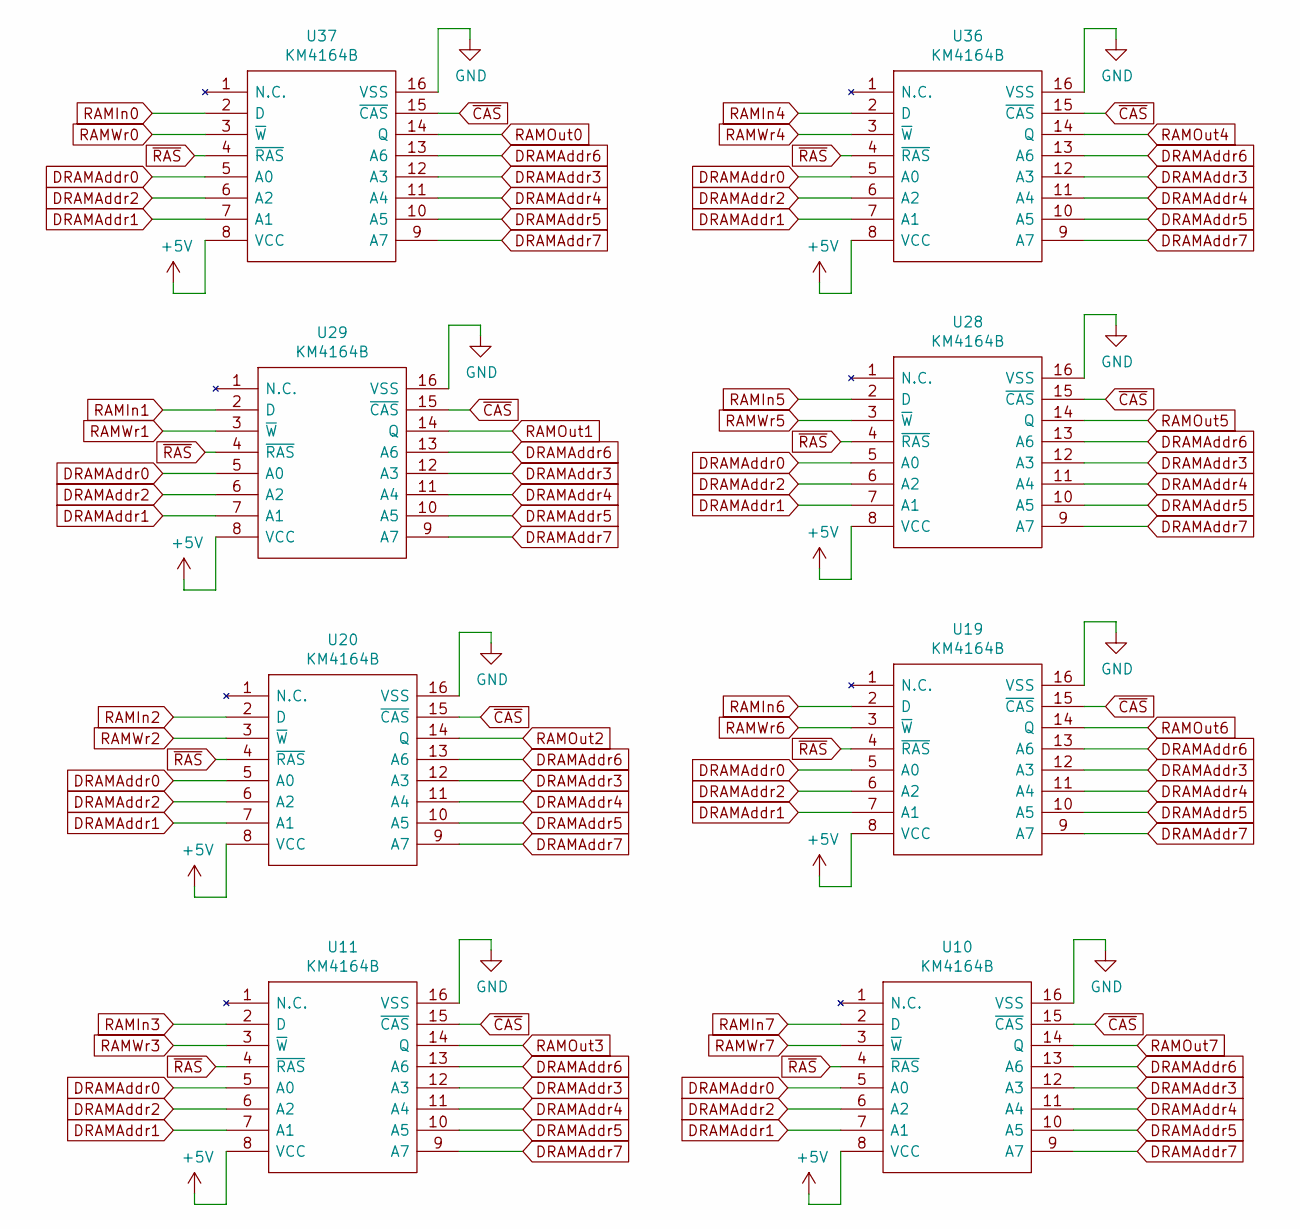
[picture p18: schematic VideoRAM.sch]

Parts:
U10, U11, U19, U20, U28, U29, U36, U37: KM4164B; DIP-16_W7.62mm_Socket; Manufacturer_Part_Number KM4164B

Connections:
+5V: U10.8 (VCC), U11.8 (VCC), U19.8 (VCC), U20.8 (VCC), U28.8 (VCC), U29.8 (VCC), U36.8 (VCC), U37.8 (VCC)
DRAMAddr0: U10.5 (A0), U11.5 (A0), U19.5 (A0), U20.5 (A0), U28.5 (A0), U29.5 (A0), U36.5 (A0), U37.5 (A0)
DRAMAddr1: U10.7 (A1), U11.7 (A1), U19.7 (A1), U20.7 (A1), U28.7 (A1), U29.7 (A1), U36.7 (A1), U37.7 (A1)
DRAMAddr2: U10.6 (A2), U11.6 (A2), U19.6 (A2), U20.6 (A2), U28.6 (A2), U29.6 (A2), U36.6 (A2), U37.6 (A2)
DRAMAddr3: U10.12 (A3), U11.12 (A3), U19.12 (A3), U20.12 (A3), U28.12 (A3), U29.12 (A3), U36.12 (A3), U37.12 (A3)
DRAMAddr4: U10.11 (A4), U11.11 (A4), U19.11 (A4), U20.11 (A4), U28.11 (A4), U29.11 (A4), U36.11 (A4), U37.11 (A4)
DRAMAddr5: U10.10 (A5), U11.10 (A5), U19.10 (A5), U20.10 (A5), U28.10 (A5), U29.10 (A5), U36.10 (A5), U37.10 (A5)
DRAMAddr6: U10.13 (A6), U11.13 (A6), U19.13 (A6), U20.13 (A6), U28.13 (A6), U29.13 (A6), U36.13 (A6), U37.13 (A6)
DRAMAddr7: U10.9 (A7), U11.9 (A7), U19.9 (A7), U20.9 (A7), U28.9 (A7), U29.9 (A7), U36.9 (A7), U37.9 (A7)
GND: U10.16 (VSS), U11.16 (VSS), U19.16 (VSS), U20.16 (VSS), U28.16 (VSS), U29.16 (VSS), U36.16 (VSS), U37.16 (VSS)
RAMIn0: U37.2 (D)
RAMIn1: U29.2 (D)
RAMIn2: U20.2 (D)
RAMIn3: U11.2 (D)
RAMIn4: U36.2 (D)
RAMIn5: U28.2 (D)
RAMIn6: U19.2 (D)
RAMIn7: U10.2 (D)
RAMOut0: U37.14 (Q)
RAMOut1: U29.14 (Q)
RAMOut2: U20.14 (Q)
RAMOut3: U11.14 (Q)
RAMOut4: U36.14 (Q)
RAMOut5: U28.14 (Q)
RAMOut6: U19.14 (Q)
RAMOut7: U10.14 (Q)
RAMWr0: U37.3 (~W)
RAMWr1: U29.3 (~W)
RAMWr2: U20.3 (~W)
RAMWr3: U11.3 (~W)
RAMWr4: U36.3 (~W)
RAMWr5: U28.3 (~W)
RAMWr6: U19.3 (~W)
RAMWr7: U10.3 (~W)
~CAS: U10.15 (~CAS), U11.15 (~CAS), U19.15 (~CAS), U20.15 (~CAS), U28.15 (~CAS), U29.15 (~CAS), U36.15 (~CAS), U37.15 (~CAS)
~RAS: U10.4 (~RAS), U11.4 (~RAS), U19.4 (~RAS), U20.4 (~RAS), U28.4 (~RAS), U29.4 (~RAS), U36.4 (~RAS), U37.4 (~RAS)
