na103/rainbow100-gs2/kicad/Graphics-V2/VideoShiftReg.sch

## KiCad design kicad/Graphics-V2/VideoShiftReg.sch (2023-01-17)

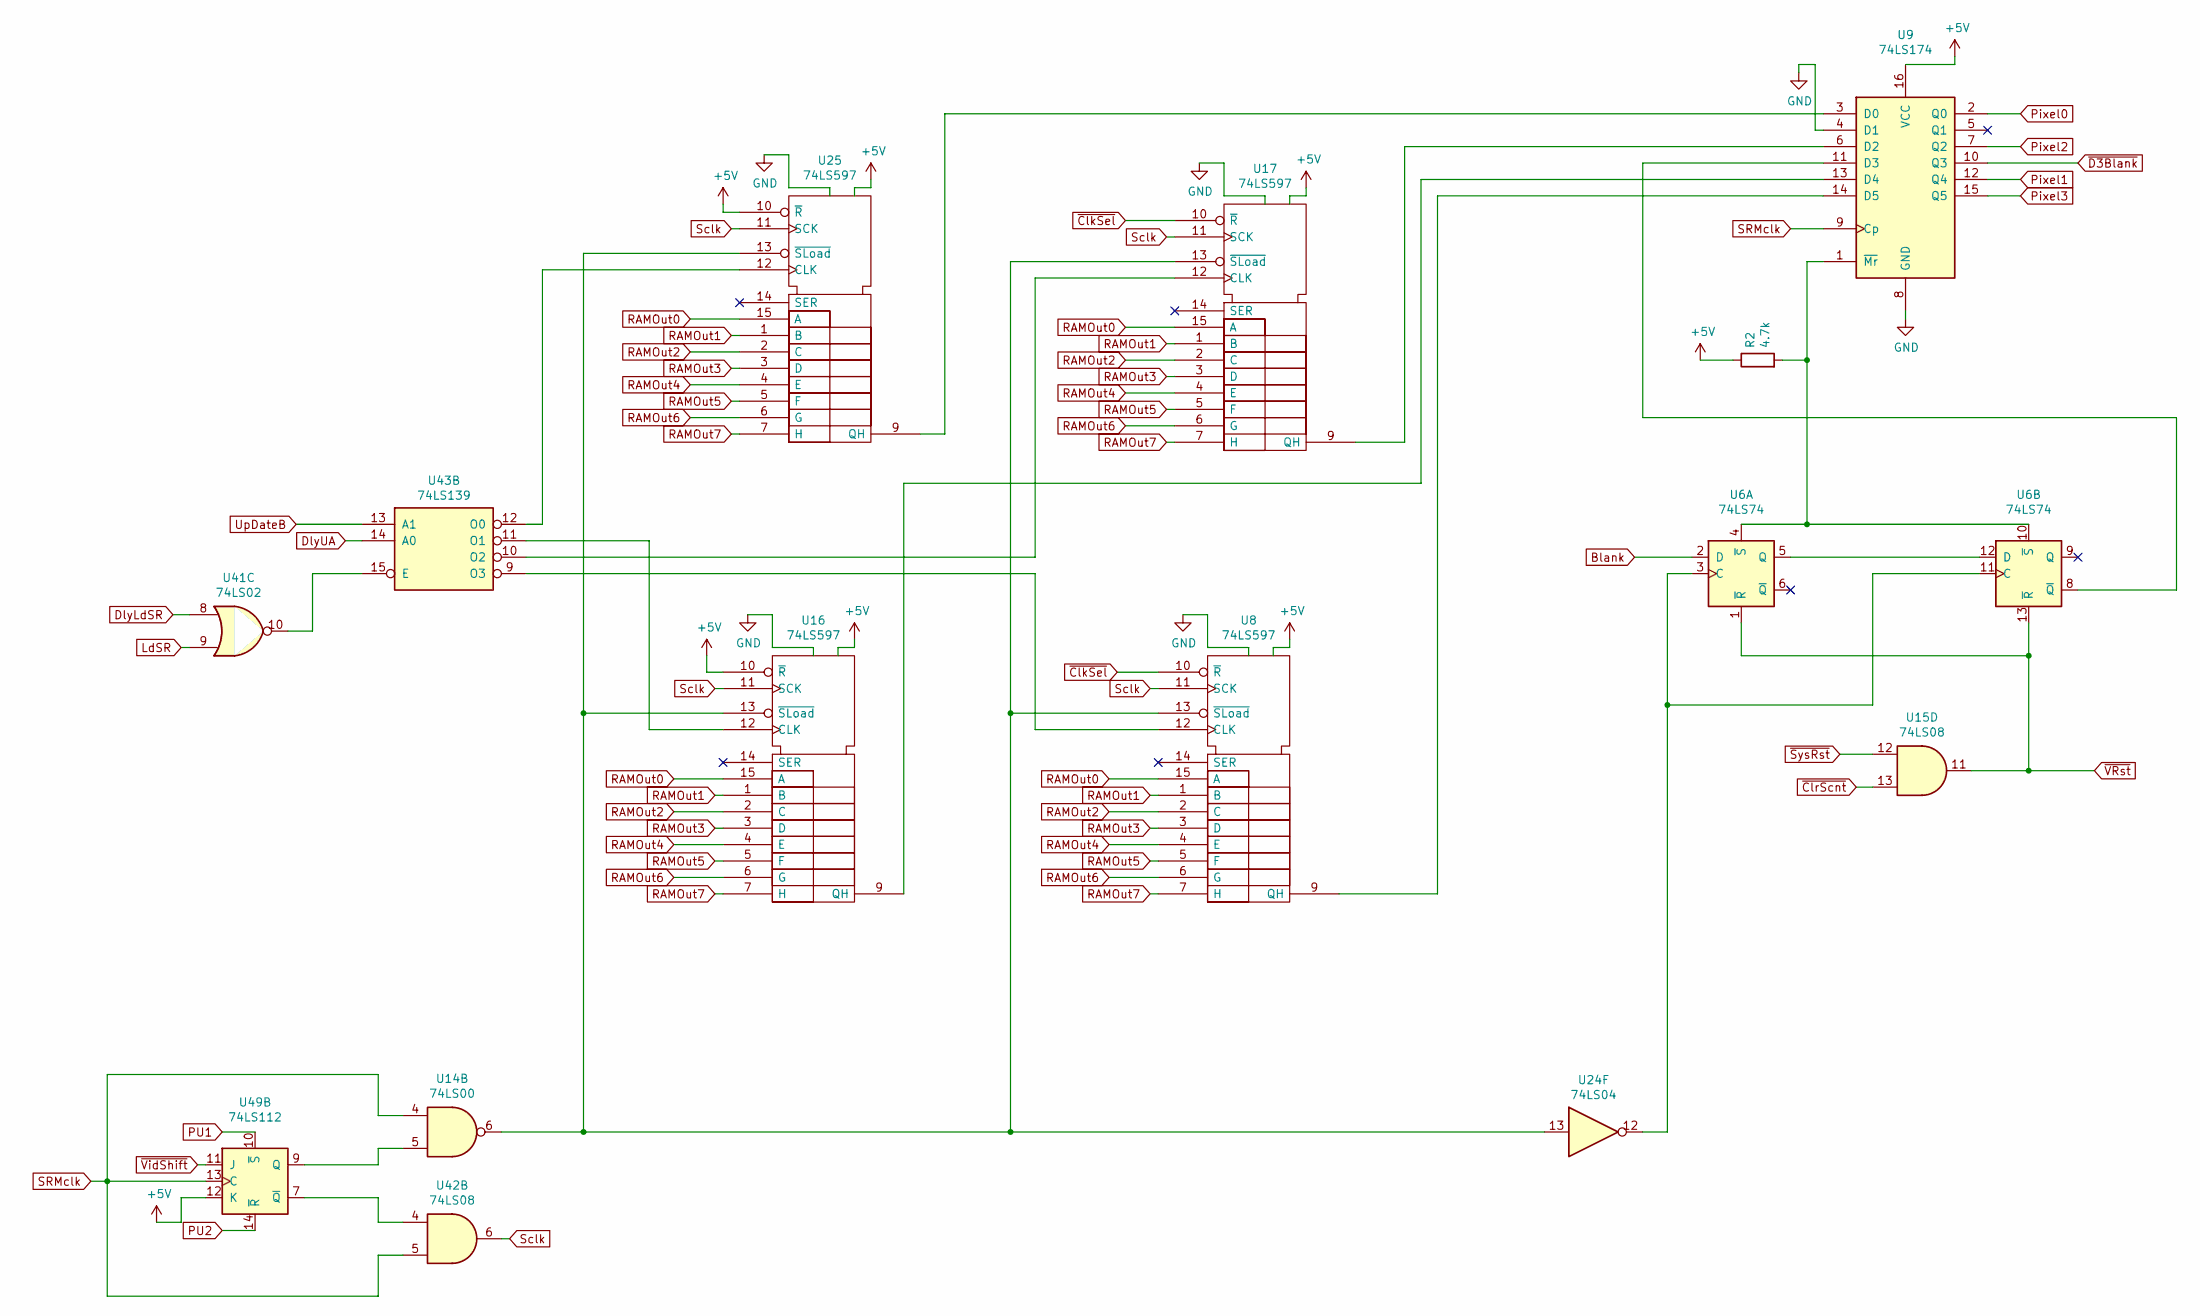
[picture p19: schematic VideoShiftReg.sch]

Parts:
R2: 4.7k; R_Axial_DIN0207_L6.3mm_D2.5mm_P10.16mm_Horizontal
U6: 74LS74; DIP-14_W7.62mm
U8, U16, U17, U25: 74LS597; DIP-16_W7.62mm
U9: 74LS174; DIP-16_W7.62mm
U14: 74LS00; DIP-14_W7.62mm
U15, U42: 74LS08; DIP-14_W7.62mm
U24: 74LS04; DIP-14_W7.62mm
U41: 74LS02; DIP-14_W7.62mm
U43: 74LS139; DIP-16_W7.62mm
U49: 74LS112; DIP-16_W7.62mm

Connections:
+5V: R2.1, U8.16 (VCC), U9.16 (VCC), U16.10 (~R), U16.16 (VCC), U17.16 (VCC), U25.10 (~R), U25.16 (VCC), U49.12 (K)
Blank: U6.2 (D)
DlyLdSR: U41.8
DlyUA: U43.14 (A0)
GND: U8.8 (GND), U9.4 (D1), U9.8 (GND), U16.8 (GND), U17.8 (GND), U25.8 (GND)
LdSR: U41.9
unnamed: R2.2, U6.4 (~S), U6.10 (~S), U9.1 (~Mr)
unnamed: U6.8 (~Q), U9.11 (D3)
unnamed: U6.5 (Q), U6.12 (D)
unnamed: U8.9 (QH), U9.14 (D5)
unnamed: U14.5, U49.9 (Q)
unnamed: U8.13 (~SLoad), U14.6, U16.13 (~SLoad), U17.13 (~SLoad), U24.13, U25.13 (~SLoad)
unnamed: U9.13 (D4), U16.9 (QH)
unnamed: U16.12 (CLK), U43.11 (O1)
unnamed: U9.6 (D2), U17.9 (QH)
unnamed: U17.12 (CLK), U43.10 (O2)
unnamed: U6.3 (C), U6.11 (C), U24.12
unnamed: U9.3 (D0), U25.9 (QH)
unnamed: U25.12 (CLK), U43.12 (O0)
unnamed: U41.10, U43.15 (E)
unnamed: U42.4, U49.7 (~Q)
unnamed: U8.12 (CLK), U43.9 (O3)
PU1: U49.10 (~S)
PU2: U49.14 (~R)
Pixel0: U9.2 (Q0)
Pixel1: U9.12 (Q4)
Pixel2: U9.7 (Q2)
Pixel3: U9.15 (Q5)
RAMOut0: U8.15 (A), U16.15 (A), U17.15 (A), U25.15 (A)
RAMOut1: U8.1 (B), U16.1 (B), U17.1 (B), U25.1 (B)
RAMOut2: U8.2 (C), U16.2 (C), U17.2 (C), U25.2 (C)
RAMOut3: U8.3 (D), U16.3 (D), U17.3 (D), U25.3 (D)
RAMOut4: U8.4 (E), U16.4 (E), U17.4 (E), U25.4 (E)
RAMOut5: U8.5 (F), U16.5 (F), U17.5 (F), U25.5 (F)
RAMOut6: U8.6 (G), U16.6 (G), U17.6 (G), U25.6 (G)
RAMOut7: U8.7 (H), U16.7 (H), U17.7 (H), U25.7 (H)
SRMclk: U9.9 (Cp), U14.4, U42.5, U49.13 (C)
Sclk: U8.11 (SCK), U16.11 (SCK), U17.11 (SCK), U25.11 (SCK), U42.6
UpDateB: U43.13 (A1)
~ClkSel: U8.10 (~R), U17.10 (~R)
~ClrScnt: U15.13
~D3Blank: U9.10 (Q3)
~SysRst: U15.12
~VRst: U6.1 (~R), U6.13 (~R), U15.11
~VidShift: U49.11 (J)
