na103/rainbow100-gs2/kicad/Graphics-V2/gdc.sch

## KiCad design kicad/Graphics-V2/gdc.sch (2023-01-17)

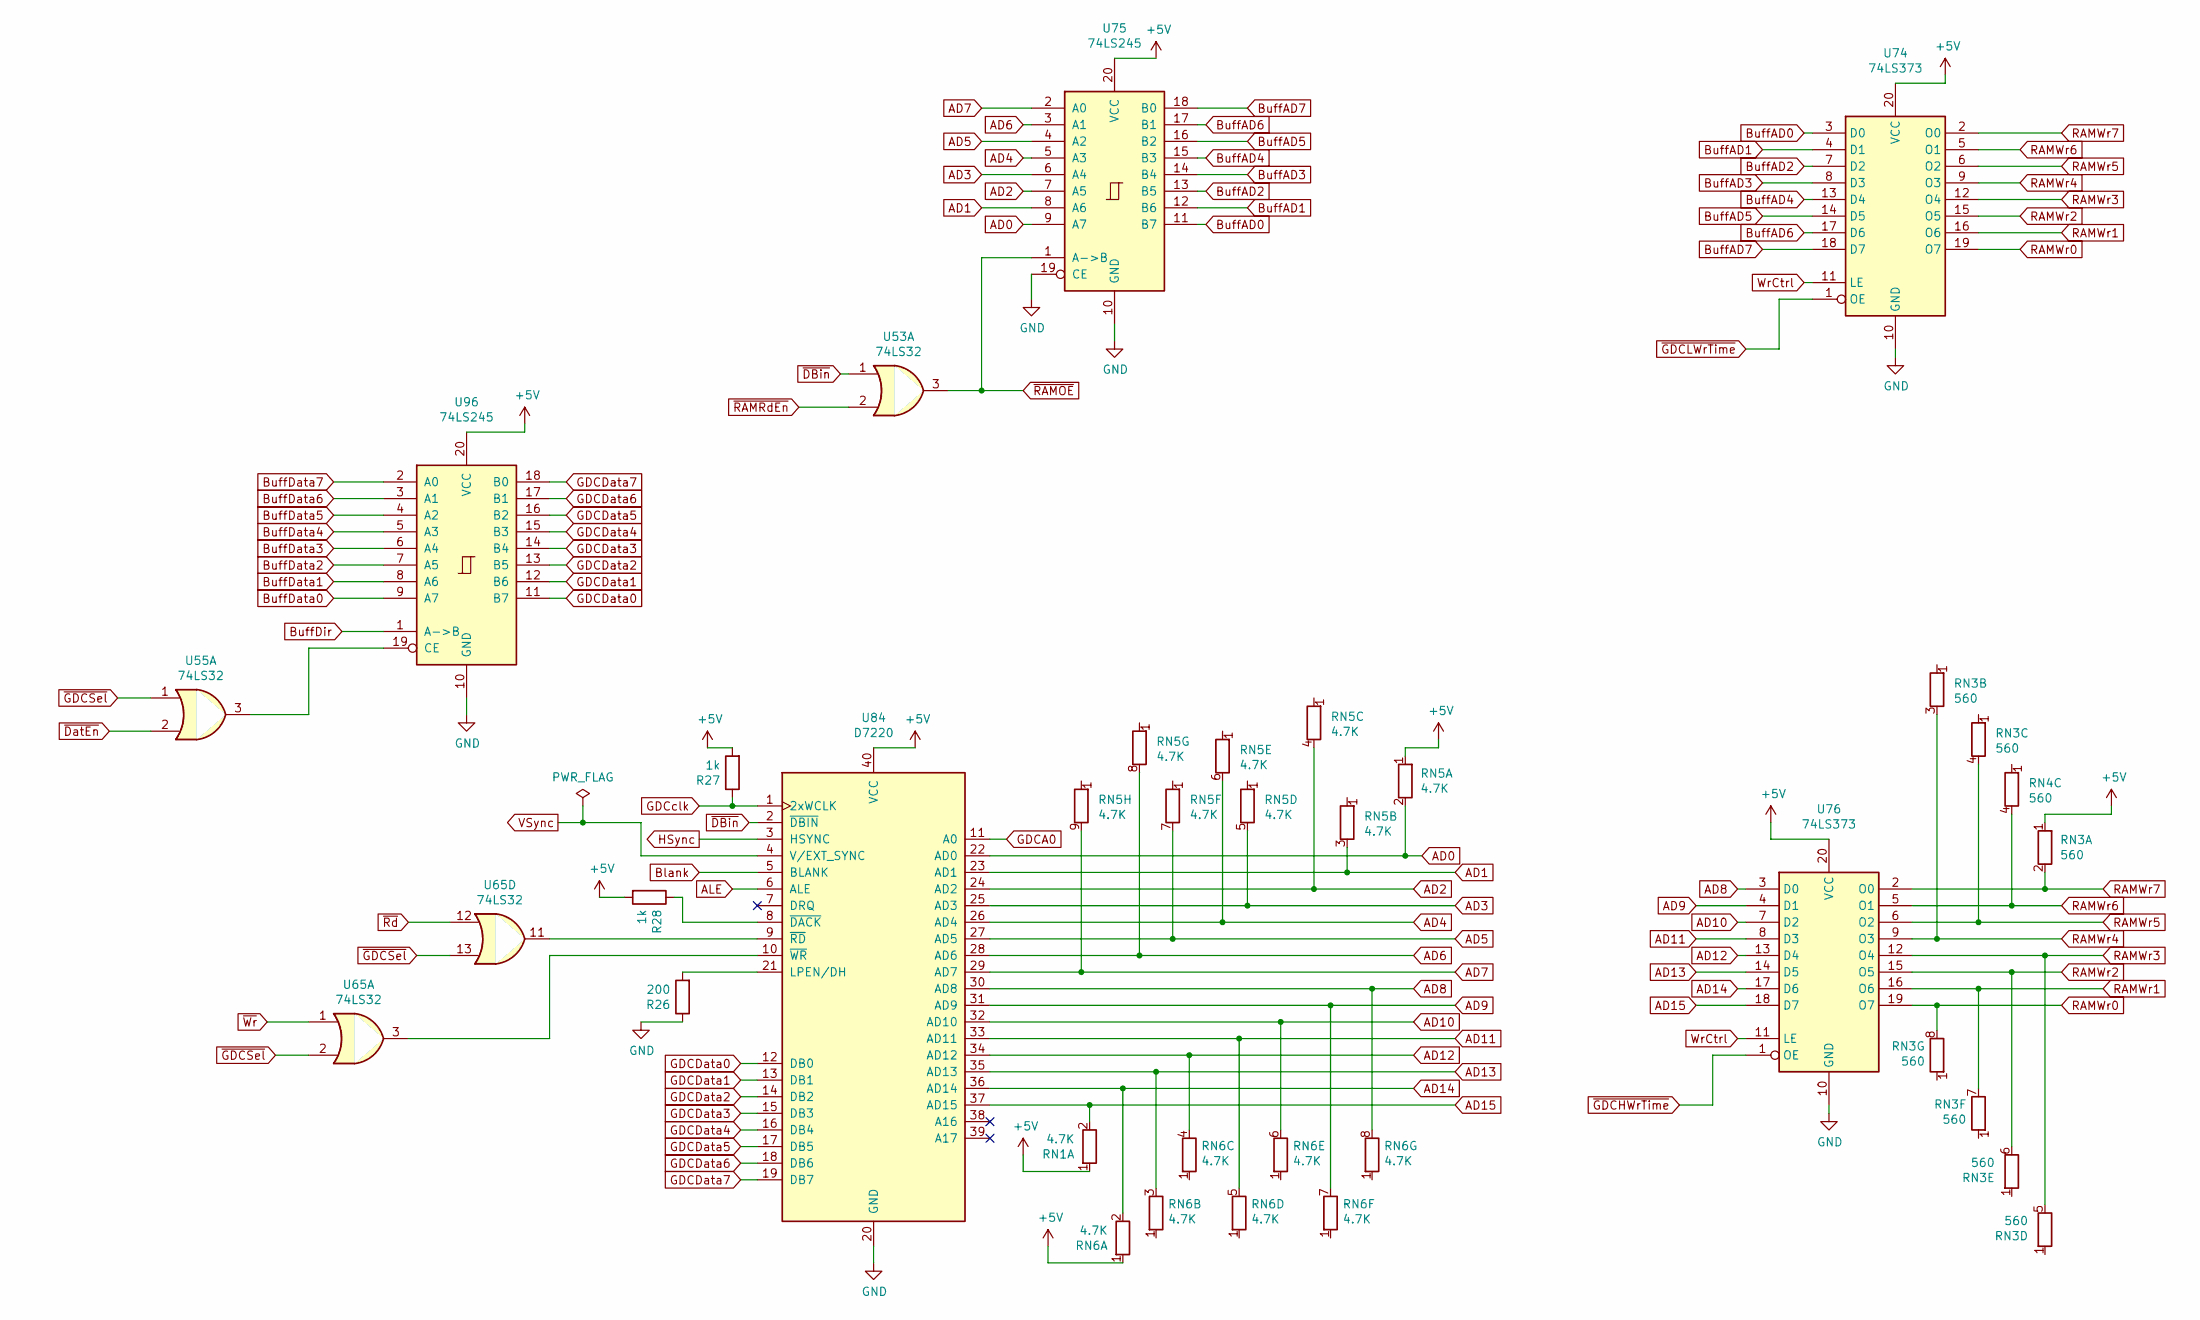
[picture p20: schematic gdc.sch]

Parts:
R26: 200; R_Axial_DIN0207_L6.3mm_D2.5mm_P10.16mm_Horizontal
R27, R28: 1k; R_Axial_DIN0207_L6.3mm_D2.5mm_P10.16mm_Horizontal
RN1, RN6: 4.7K; R_Array_SIP8
RN3, RN4: 560; R_Array_SIP8
RN5: 4.7K; R_Array_SIP9
U53, U55, U65: 74LS32; DIP-14_W7.62mm
U74, U76: 74LS373; DIP-20_W7.62mm
U75, U96: 74LS245; DIP-20_W7.62mm
U84: D7220; DIP-40_W15.24mm_Socket

Connections:
+5V: R27.2, R28.2, RN1.1 (R1.1), RN3.1 (R1.1), RN5.1 (R1.1), RN6.1 (R1.1), U74.20 (VCC), U75.20 (VCC), U76.20 (VCC), U84.40 (VCC), U96.20 (VCC)
AD0: RN5.2 (R1.2), U75.9 (A7), U84.22 (AD0)
AD1: RN5.3 (R2.2), U75.8 (A6), U84.23 (AD1)
AD2: RN5.4 (R3.2), U75.7 (A5), U84.24 (AD2)
AD3: RN5.5 (R4.2), U75.6 (A4), U84.25 (AD3)
AD4: RN5.6 (R5.2), U75.5 (A3), U84.26 (AD4)
AD5: RN5.7 (R6.2), U75.4 (A2), U84.27 (AD5)
AD6: RN5.8 (R7.2), U75.3 (A1), U84.28 (AD6)
AD7: RN5.9 (R8.2), U75.2 (A0), U84.29 (AD7)
AD8: RN6.8 (R7.2), U76.3 (D0), U84.30 (AD8)
AD9: RN6.7 (R6.2), U76.4 (D1), U84.31 (AD9)
AD10: RN6.6 (R5.2), U76.7 (D2), U84.32 (AD10)
AD11: RN6.5 (R4.2), U76.8 (D3), U84.33 (AD11)
AD12: RN6.4 (R3.2), U76.13 (D4), U84.34 (AD12)
AD13: RN6.3 (R2.2), U76.14 (D5), U84.35 (AD13)
AD14: RN6.2 (R1.2), U76.17 (D6), U84.36 (AD14)
AD15: RN1.2 (R1.2), U76.18 (D7), U84.37 (AD15)
ALE: U84.6 (ALE)
Blank: U84.5 (BLANK)
BuffAD0: U74.3 (D0), U75.11 (B7)
BuffAD1: U74.4 (D1), U75.12 (B6)
BuffAD2: U74.7 (D2), U75.13 (B5)
BuffAD3: U74.8 (D3), U75.14 (B4)
BuffAD4: U74.13 (D4), U75.15 (B3)
BuffAD5: U74.14 (D5), U75.16 (B2)
BuffAD6: U74.17 (D6), U75.17 (B1)
BuffAD7: U74.18 (D7), U75.18 (B0)
BuffData0: U96.9 (A7)
BuffData1: U96.8 (A6)
BuffData2: U96.7 (A5)
BuffData3: U96.6 (A4)
BuffData4: U96.5 (A3)
BuffData5: U96.4 (A2)
BuffData6: U96.3 (A1)
BuffData7: U96.2 (A0)
BuffDir: U96.1 (A->B)
GDCA0: U84.11 (A0)
GDCData0: U84.12 (DB0), U96.11 (B7)
GDCData1: U84.13 (DB1), U96.12 (B6)
GDCData2: U84.14 (DB2), U96.13 (B5)
GDCData3: U84.15 (DB3), U96.14 (B4)
GDCData4: U84.16 (DB4), U96.15 (B3)
GDCData5: U84.17 (DB5), U96.16 (B2)
GDCData6: U84.18 (DB6), U96.17 (B1)
GDCData7: U84.19 (DB7), U96.18 (B0)
GDCclk: R27.1, U84.1 (2xWCLK)
GND: R26.1, U74.10 (GND), U75.10 (GND), U75.19 (CE), U76.10 (GND), U84.20 (GND), U96.10 (GND)
HSync: U84.3 (HSYNC)
unnamed: R26.2, U84.21 (LPEN/DH)
unnamed: R28.1, U84.8 (~DACK~)
unnamed: U55.3, U96.19 (CE)
unnamed: U65.3, U84.10 (~WR)
unnamed: U65.11, U84.9 (~RD)
RAMWr0: RN3.8 (R7.2), U74.19 (O7), U76.19 (O7)
RAMWr1: RN3.7 (R6.2), U74.16 (O6), U76.16 (O6)
RAMWr2: RN3.6 (R5.2), U74.15 (O5), U76.15 (O5)
RAMWr3: RN3.5 (R4.2), U74.12 (O4), U76.12 (O4)
RAMWr4: RN3.3 (R2.2), U74.9 (O3), U76.9 (O3)
RAMWr5: RN3.4 (R3.2), U74.6 (O2), U76.6 (O2)
RAMWr6: RN4.4 (R3.2), U74.5 (O1), U76.5 (O1)
RAMWr7: RN3.2 (R1.2), U74.2 (O0), U76.2 (O0)
VSync: U84.4 (V/EXT_SYNC)
WrCtrl: U74.11 (LE), U76.11 (LE)
~DBin: U53.1, U84.2 (~DBIN~)
~DatEn: U55.2
~GDCHWrTime: U76.1 (OE)
~GDCLWrTime: U74.1 (OE)
~GDCSel: U55.1, U65.2, U65.13
~RAMOE: U53.3, U75.1 (A->B)
~RAMRdEn: U53.2
~Rd: U65.12
~Wr: U65.1
