na103/rainbow100-gs2/(commit log)

2023-01-17 Kicad projects
    [CLUTAddress.sch, ColorLUT.sch, CombinerControl.sch, ControlPort.sch, DataBufferControl.sch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]
2023-01-17 proms bin, equation and truth table
    [U12-23B4.csv, U21-CF22.csv]
2023-01-17 Original board
2023-01-17 Tony Duell schematics
2023-01-17 Component list
    [BOM.xlsx]
